onigiri05/AOC_final_project/PT_DIR/README.md

把權重檔`rms_qat_best.pt`放在這個目錄下
[權重檔連結](https://drive.google.com/file/d/1NLXP_AgiUWwAuHGhvn90UVlvVOJURX59/view?usp=sharing)
