onigiri05/AOC_final_project/DLA/Streaming_RMSNorm_Unit/hardware_export/gamma_buffer/gamma_buffer_params.csv

layer | entries | bits | format | q_frac | gamma_fp32_min | gamma_fp32_max | gamma_fp32_mean | clip_low | clip_high | mem | hex | npy | bytes
blocks.0.norm1 | 384 | 16 | INT16_SQ2.14_assumed | 14 | -0.0034103195648640394 | 1.004909634590149 | 0.45875516533851624 | 0 | 0 | ckpt_flash_attn/hardware_export/gamma_buffer/blocks_0_norm1_gamma_Q2_14.mem | ckpt_flash_attn/hardware_export/gamma_buffer/blocks_0_norm1_gamma_Q2_14.hex | ckpt_flash_attn/hardware_export/gamma_buffer/blocks_0_norm1_gamma_Q2_14.npy | 768
blocks.0.norm2 | 384 | 16 | INT16_SQ2.14_assumed | 14 | -0.014030483551323414 | 2.892163038253784 | 1.123841404914856 | 0 | 92 | ckpt_flash_attn/hardware_export/gamma_buffer/blocks_0_norm2_gamma_Q2_14.mem | ckpt_flash_attn/hardware_export/gamma_buffer/blocks_0_norm2_gamma_Q2_14.hex | ckpt_flash_attn/hardware_export/gamma_buffer/blocks_0_norm2_gamma_Q2_14.npy | 768
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
