onigiri05/AOC_final_project/DLA/Streaming_RMSNorm_Unit/hardware_export/rmsnorm_inv_sqrt_lut/per_layer_B/rms_inv_sqrt_lut_B_per_layer_params.csv

layer | safe_layer | scheme | lut_bits | n_entries | output_bits | output_format | q_frac | mean_sq_min | mean_sq_max | index_scale | error_max_percent | mem | hex | coe | npy | bytes | kb
blocks.0.norm1 | blocks_0_norm1 | B_per_layer | 10 | 1024 | 16 | UINT16_UQ2.14 | 14 | 0.0 | 9.184033298492432 | 111.38896895854313 | 0.705922510402496 | ckpt_flash_attn/hardware_export/rmsnorm_inv_sqrt_lut/per_layer_B/rms_inv_sqrt_lut_B_blocks_0_norm1_10bit_Q2_14.mem | ckpt_flash_attn/hardware_export/rmsnorm_inv_sqrt_lut/per_layer_B/rms_inv_sqrt_lut_B_blocks_0_norm1_10bit_Q2_14.hex | ckpt_flash_attn/hardware_export/rmsnorm_inv_sqrt_lut/per_layer_B/rms_inv_sqrt_lut_B_blocks_0_norm1_10bit_Q2_14.coe | ckpt_flash_attn/hardware_export/rmsnorm_inv_sqrt_lut/per_layer_B/rms_inv_sqrt_lut_B_blocks_0_norm1_10bit_Q2_14.npy | 2048 | 2.0
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
