onigiri05/AOC_final_project/Profiling/outputs/bram_bytes_by_section.png

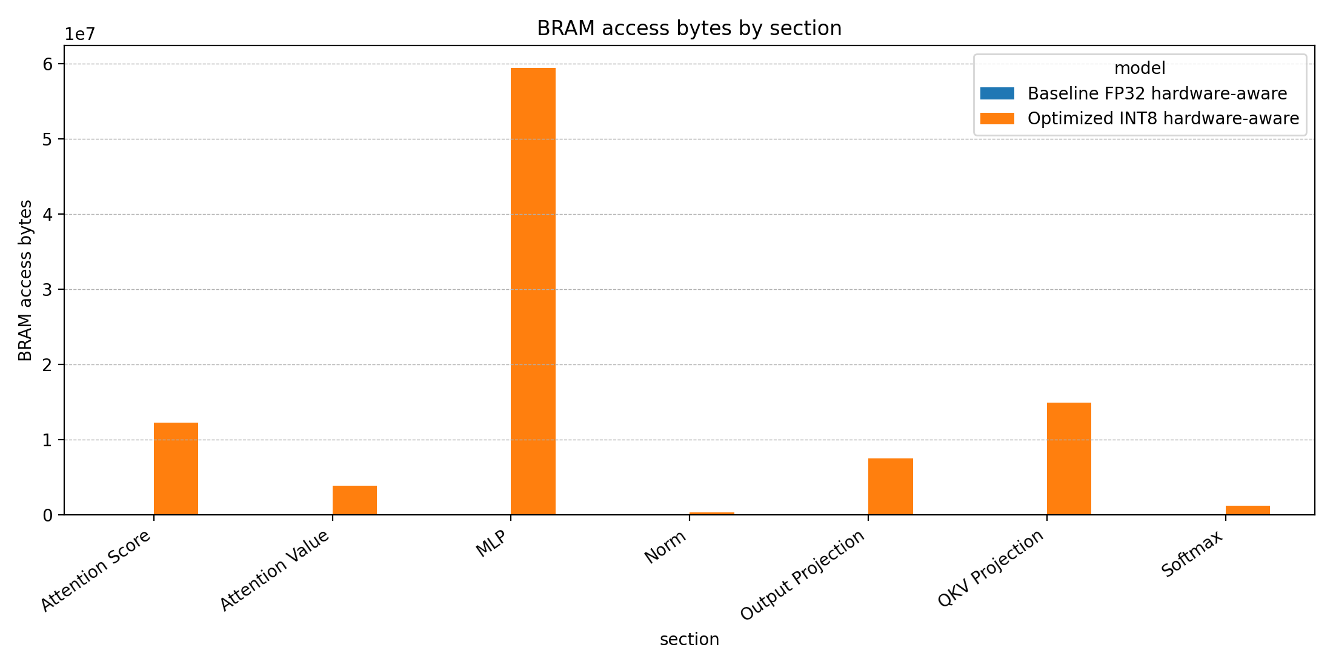
Profiling/outputs/bram_bytes_by_section.png
