onigiri05/AOC_final_project/Profiling/outputs/cycles_by_section.png

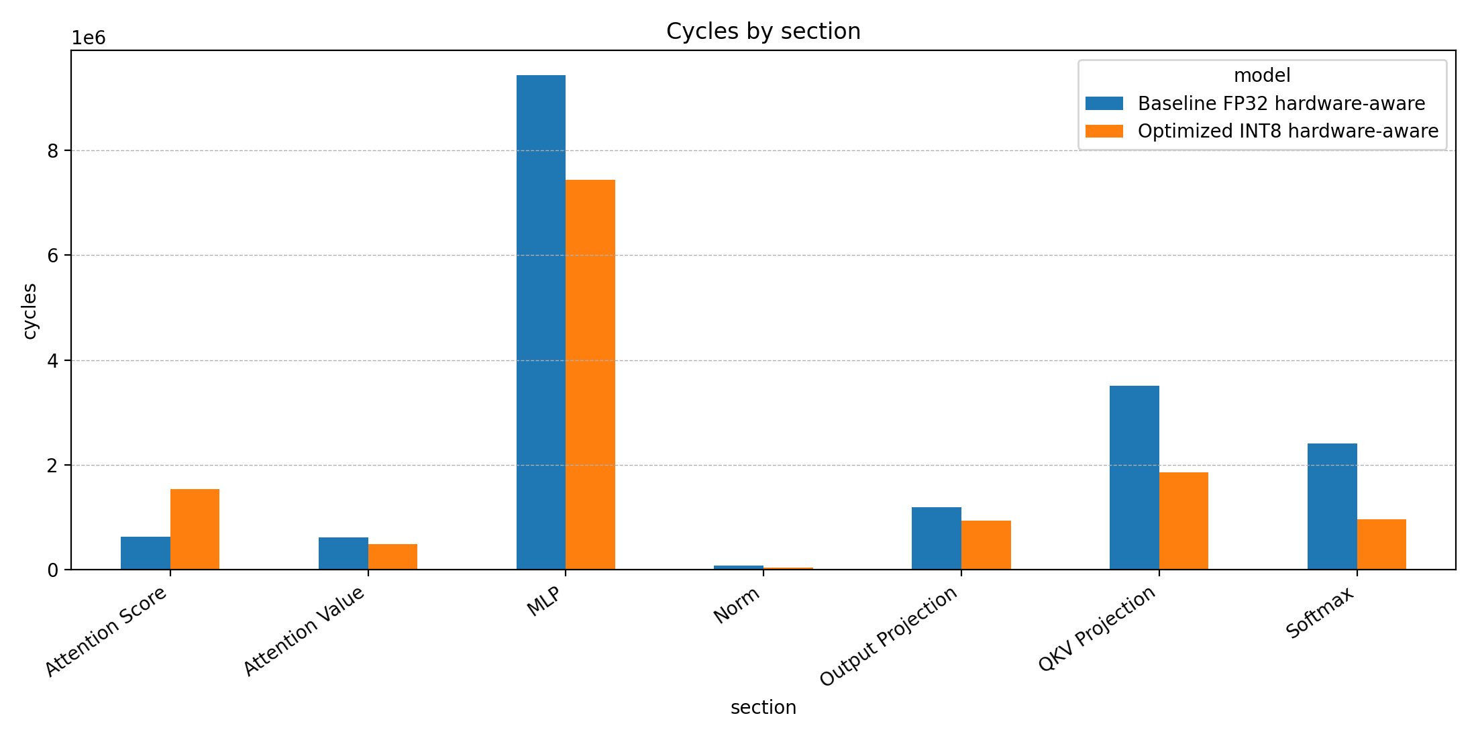
Profiling/outputs/cycles_by_section.png
