onigiri05/AOC_final_project/Profiling/outputs/cycles_norm_softmax.png

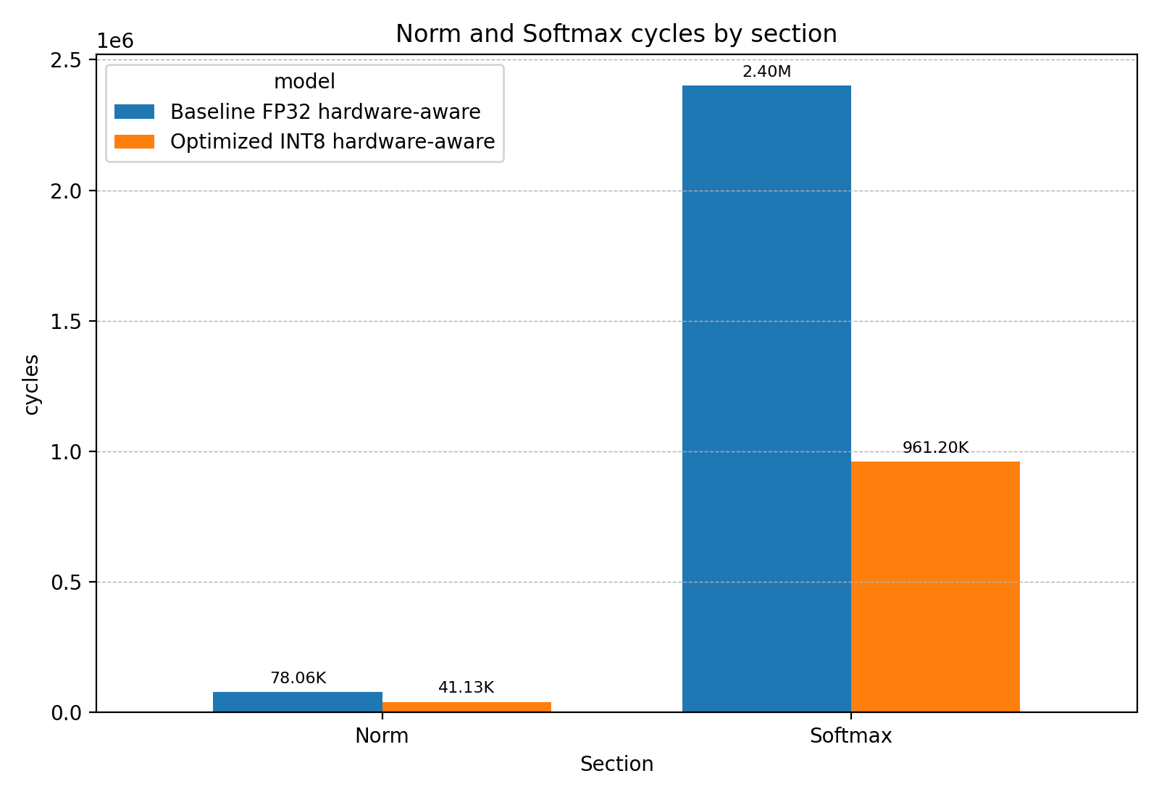
Profiling/outputs/cycles_norm_softmax.png
