onigiri05/AOC_final_project/Profiling/outputs/dram_bram_access_by_section.png

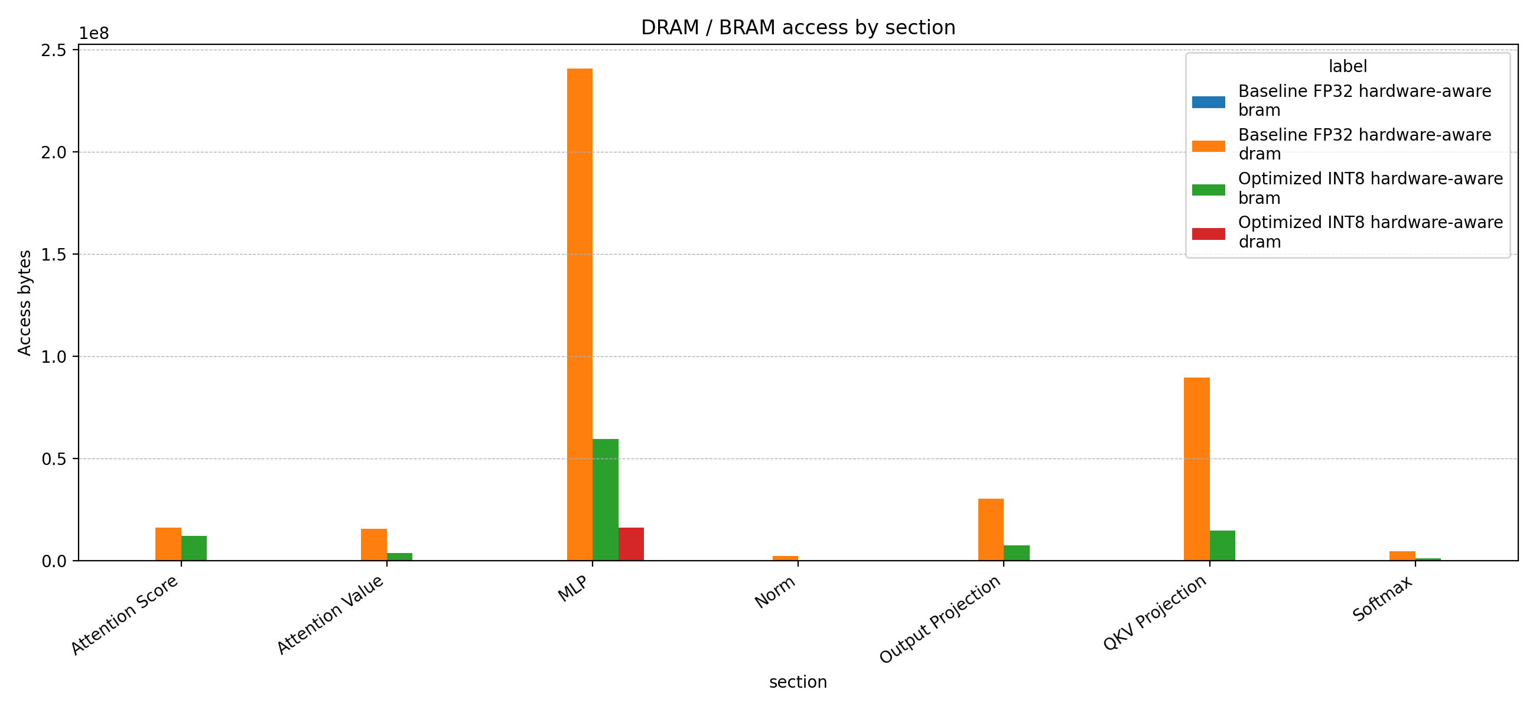
Profiling/outputs/dram_bram_access_by_section.png
