onigiri05/AOC_final_project/Profiling/outputs/energy_by_section.png

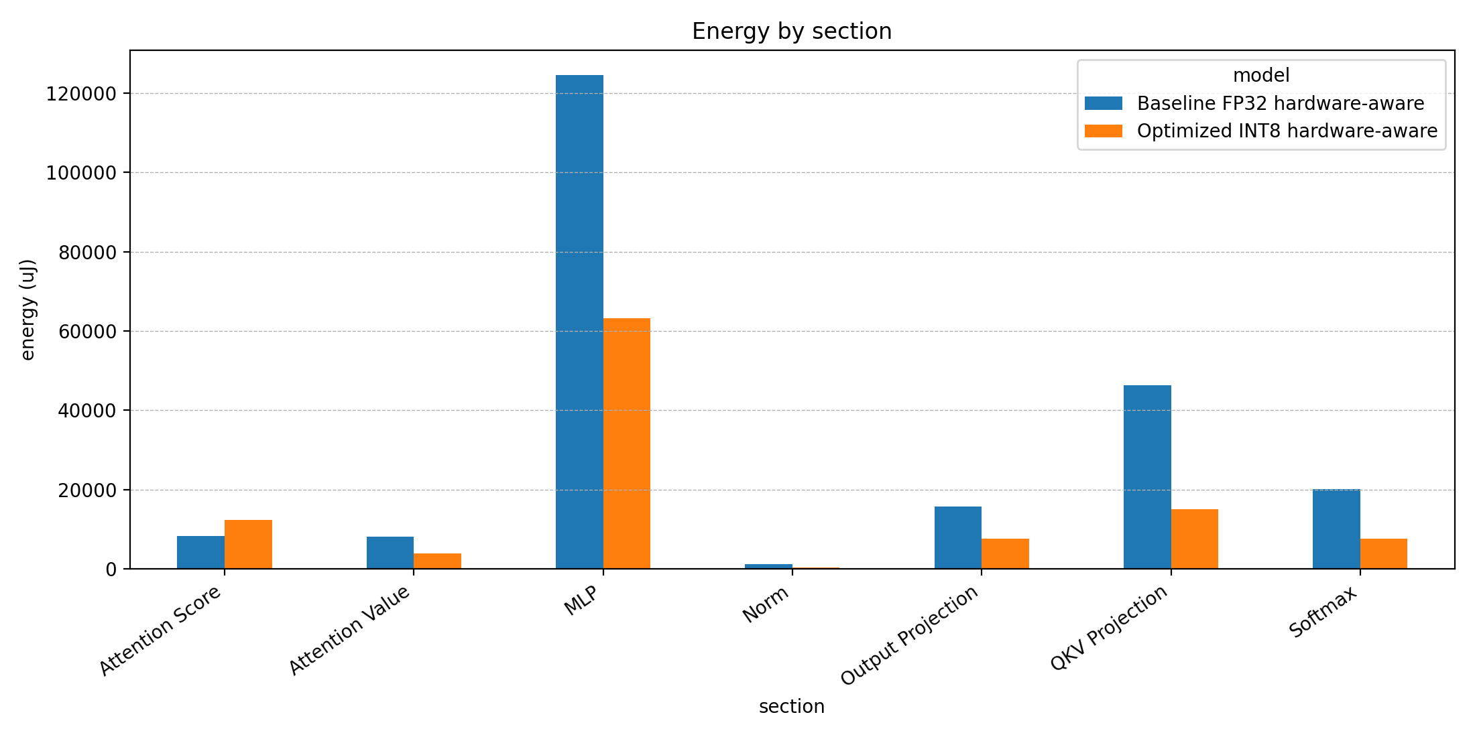
Profiling/outputs/energy_by_section.png
