onigiri05/AOC_final_project/Profiling/outputs/macs_by_section.png

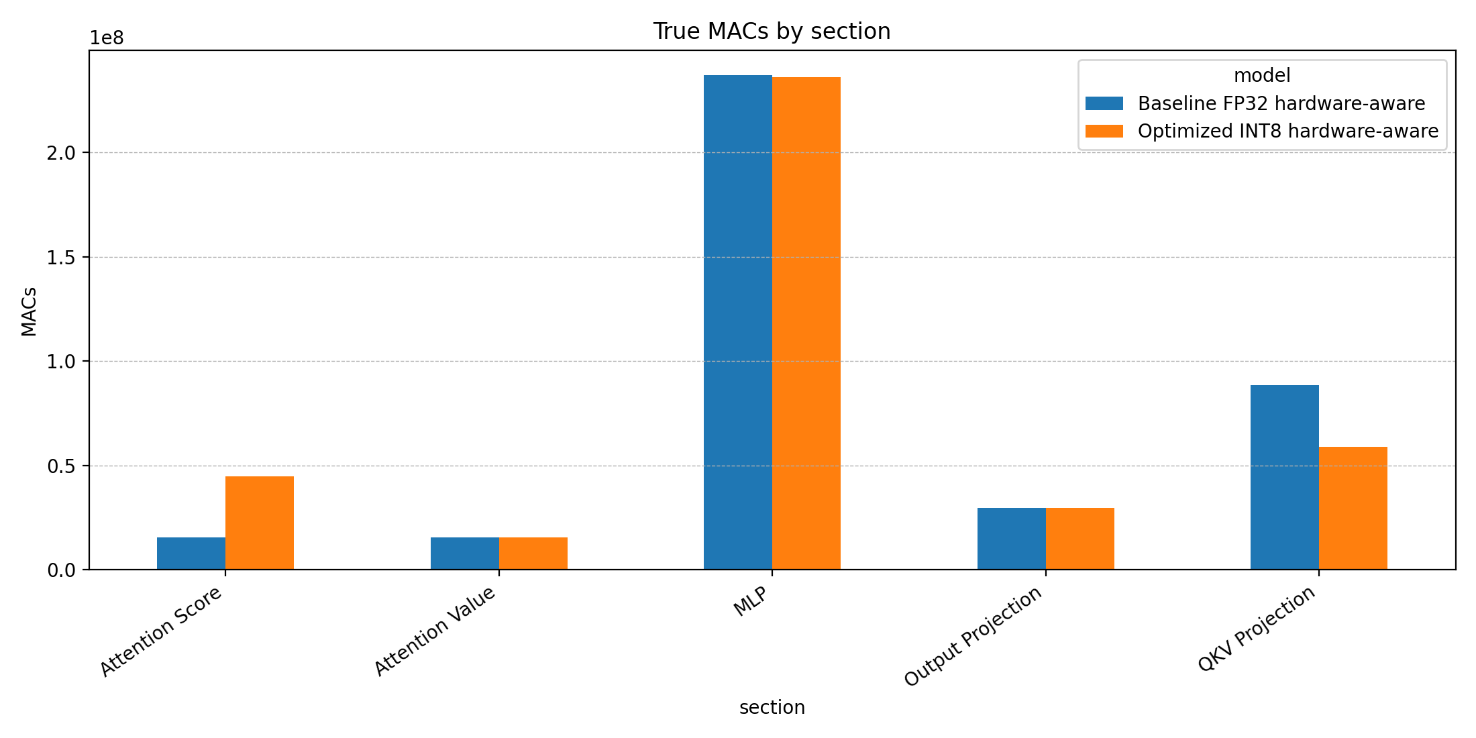
Profiling/outputs/macs_by_section.png
