onigiri05/AOC_final_project/Profiling/outputs/roofline_groups.png

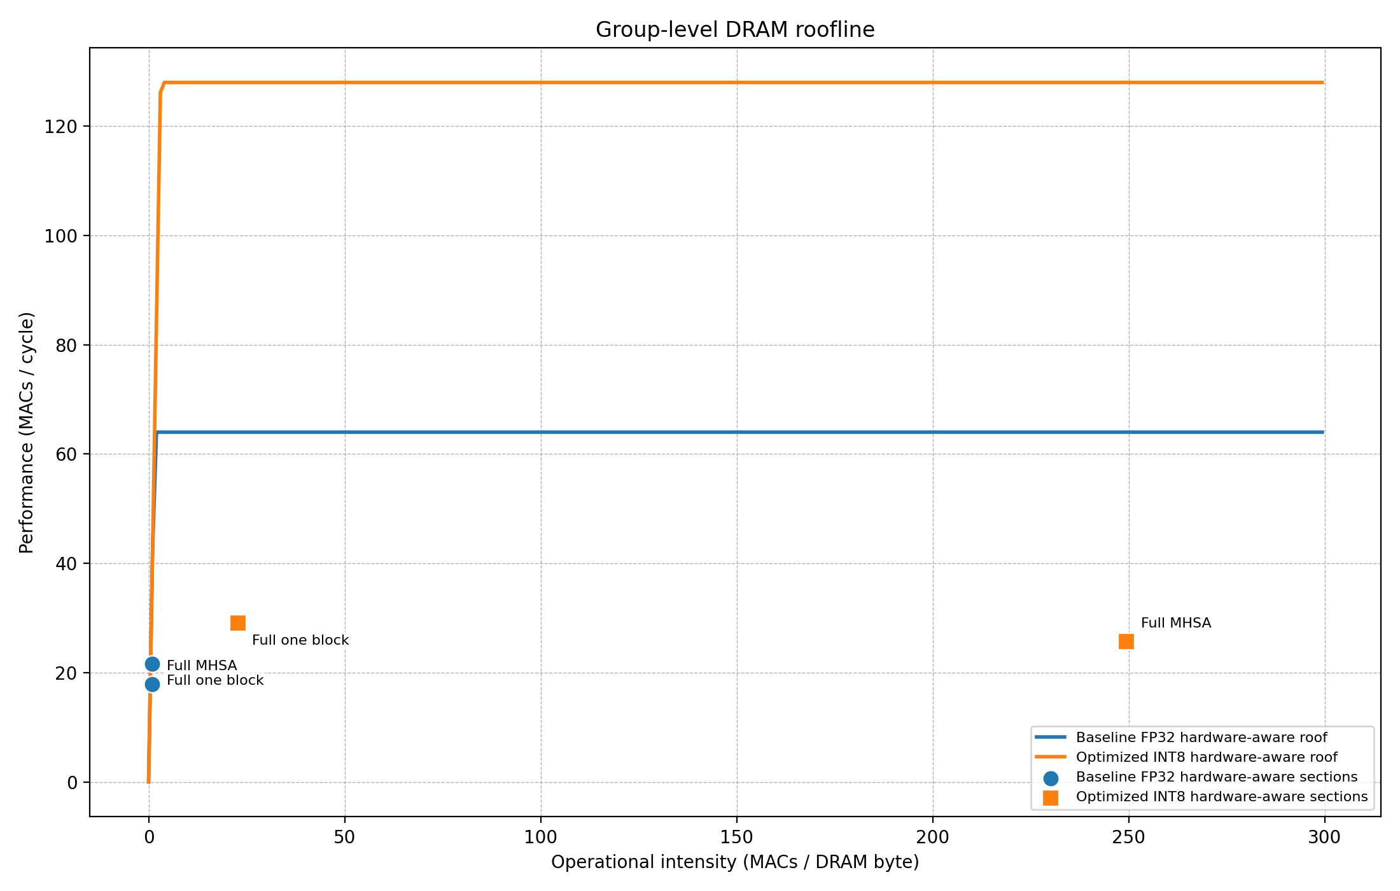
Profiling/outputs/roofline_groups.png
