onigiri05/AOC_final_project/Profiling/outputs/roofline_sections.png

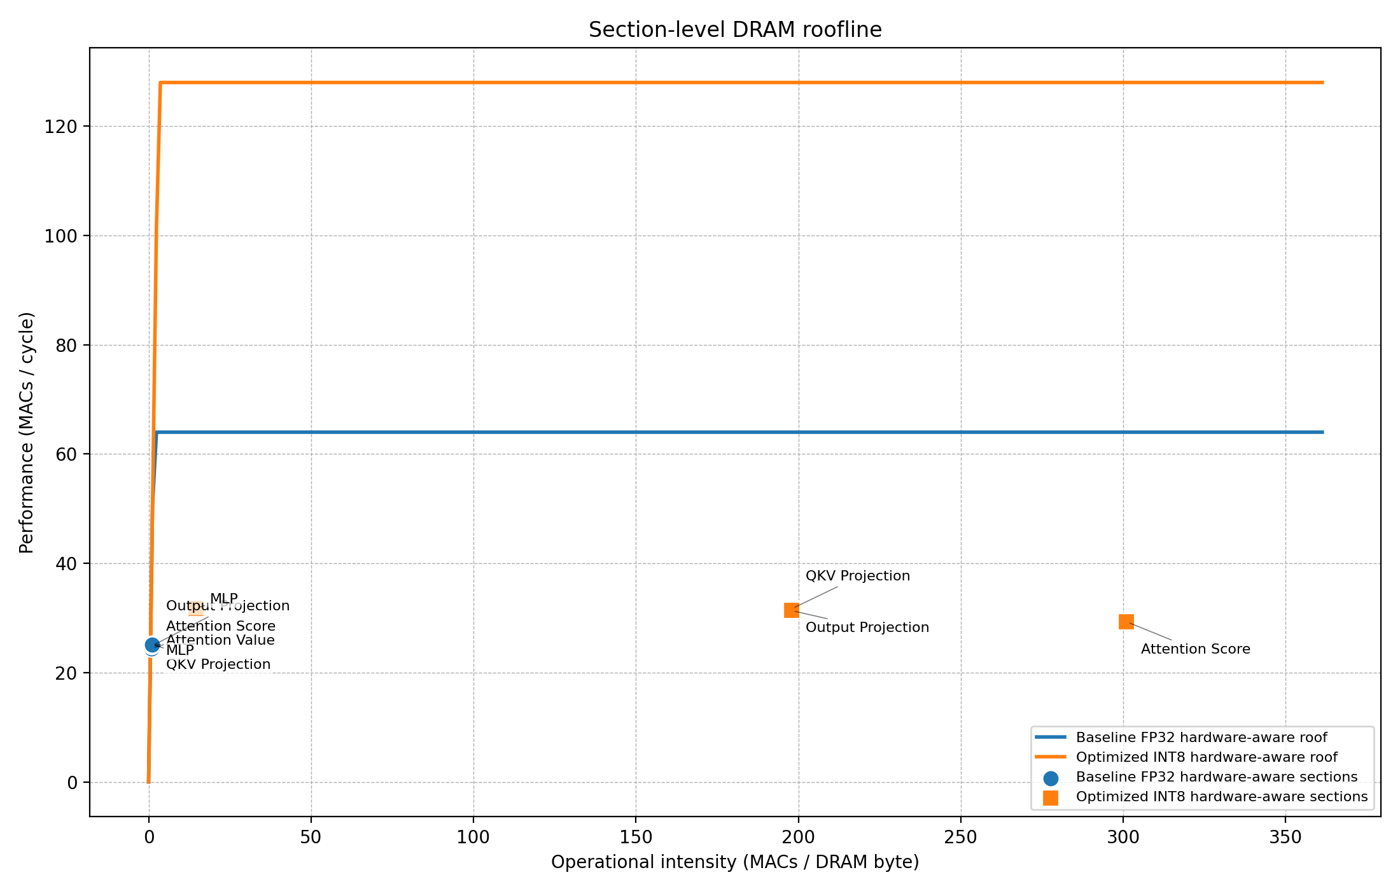
Profiling/outputs/roofline_sections.png
