onigiri05/AOC_final_project/Profiling/outputs/dram_usage_by_section.png

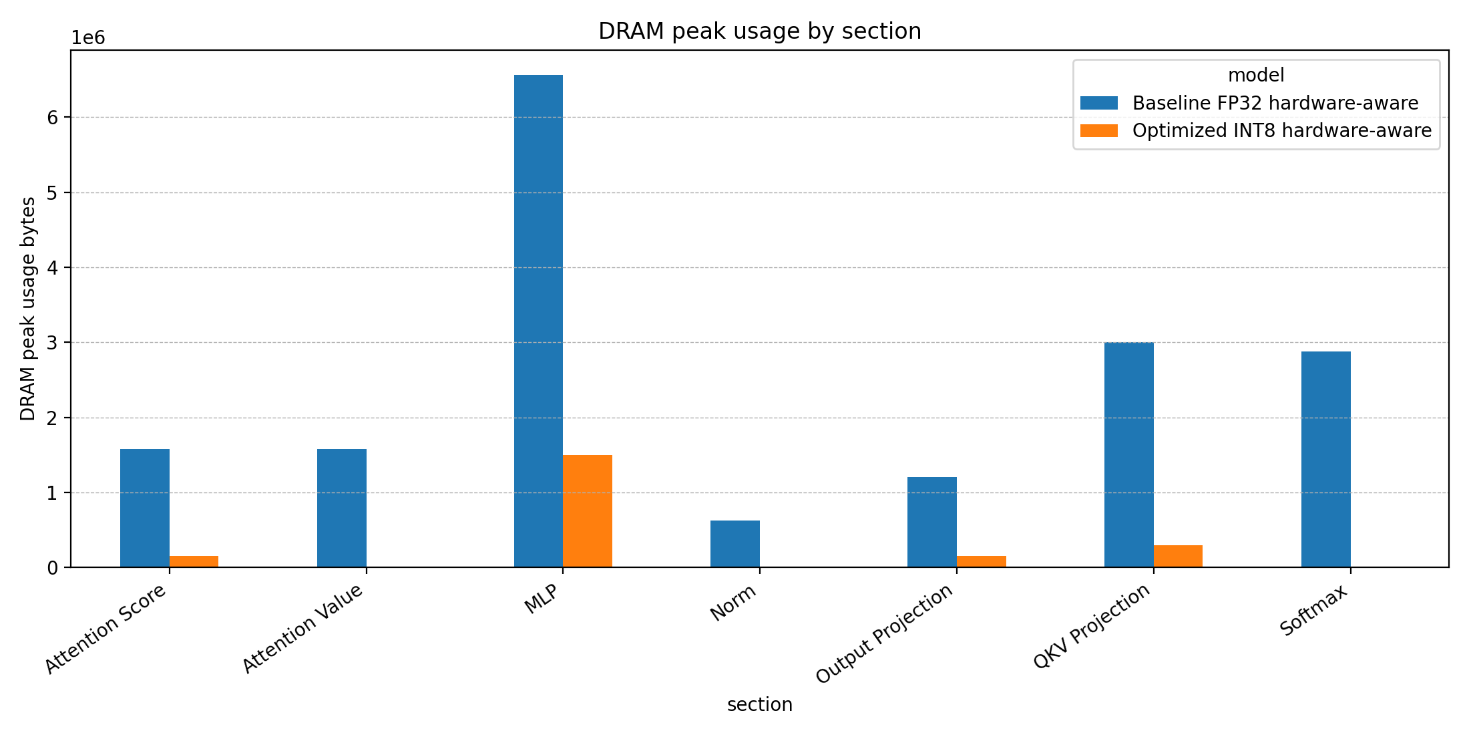
Profiling/outputs/dram_usage_by_section.png
