onigiri05/AOC_final_project/Profiling/outputs/norm_operations_by_section.png

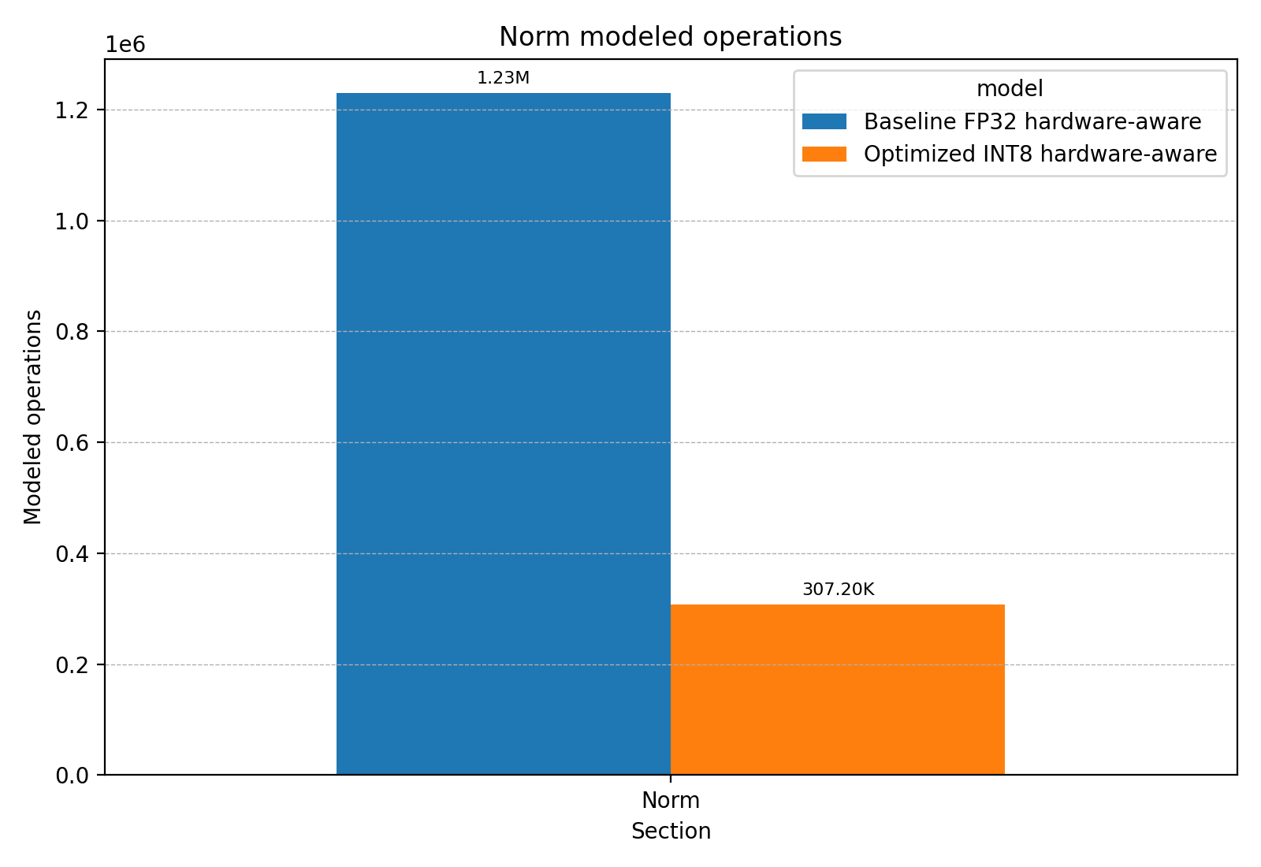
Profiling/outputs/norm_operations_by_section.png
