onigiri05/AOC_final_project/Profiling/outputs/profiling_results.md

| model | model_source | section | kind | dtype | macs | math_macs | operations | lut_accesses | dram_read_bytes | dram_write_bytes | dram_total_bytes | bram_read_bytes | bram_write_bytes | bram_total_bytes | dram_usage_bytes | bram_usage_bytes | bram_usage_ramb36 | compute_cycles | dram_cycles | bram_cycles | memory_cycles | cycles_total | latency_ms | performance_macs_per_cycle | operational_intensity | total_memory_intensity | peak_macs_per_cycle | peak_dram_bytes_per_cycle | bound | energy_compute_uj | energy_bram_uj | energy_dram_uj | energy_lut_uj | energy_leakage_uj | energy_total_uj | notes |
|:---|:---|:---|:---|:---|---:|---:|---:|---:|---:|---:|---:|---:|---:|---:|---:|---:|---:|---:|---:|---:|---:|---:|---:|---:|---:|---:|---:|---:|:---|---:|---:|---:|---:|---:|---:|:---|
| Baseline FP32 hardware-aware  | parsed_from_timm | Norm | elementwise | FP32 | 0 | 0 | 1229600 | 0 | 1854144 | 617600 | 2471744 | 0 | 0 | 0 | 623744 | 0 | 0 | 19212.5 |  58851 | 0 |  58851 |  78063.5 | 3.12254 | 0 | nan | nan | 64 | 42 | memory | 4.9184 | 0 | 494.349  | 0 | 624.508 | 1123.78  | Baseline-B: FP32 all-DRAM tiled model using the same RTL 8x8 tile size; no BRAM reuse. LayerNorm true MACs are 0; detailed modeled operations are reported separately. |
| Baseline FP32 hardware-aware  | parsed_from_timm | QKV Projection | gemm | FP32 |  88473600 | 88473600 | 0 | 0 | 88588800 | 921600 | 89510400 | 0 | 0 | 0 | 3002880 | 0 | 0 | 1.3824e+06 | 2.1312e+06  | 0 | 2.1312e+06  | 3.5136e+06  | 140.544 | 25.1803 | 0.988417 | 0.988417 | 64 | 42 | memory | 353.894  | 0 | 17902.1 | 0 | 28108.8 | 46364.8 | Baseline-B: FP32 all-DRAM tiled model using the same RTL 8x8 tile size; no BRAM reuse. |
| Baseline FP32 hardware-aware  | parsed_from_timm | Attention Score | gemm | FP32 |  15360000 | 15360000 | 0 | 0 | 15360000 | 960000 | 16320000 | 0 | 0 | 0 | 1574400 | 0 | 0 |  240000 | 388571 | 0 | 388571 | 628571 | 25.1429  | 24.4364 | 0.941176 | 0.941176 | 64 | 42 | memory | 61.44 | 0 | 3264 | 0 | 5028.57  | 8354.01  | Baseline-B: FP32 all-DRAM tiled model using the same RTL 8x8 tile size; no BRAM reuse. |
| Baseline FP32 hardware-aware  | parsed_from_timm | Softmax | softmax | FP32 | 0 | 0 | 2400000 | 0 | 2880000 | 1920000 | 4800000 | 0 | 0 | 0 | 2880000 | 0 | 0 | 37500 | 114286 | 0 | 114286 | 2.4012e+06  | 96.048 | 0 | nan | nan | 64 | 42 | memory | 9.6 | 0 | 960 | 0 | 19209.6 | 20179.2 | Baseline-B: FP32 all-DRAM tiled model using the same RTL 8x8 tile size; no BRAM reuse. Standard FP32 softmax all-DRAM memory model. True MACs are 0 because Softmax is non-GEMM; the operations column reports modeled row-wise softmax cost with FP32 exp/div initiation intervals exp_ii=4, div_ii=4. Baseline FP32 Softmax uses row-wise FSM latency with explicit exp/div IIs: rows*((2+exp_ii+div_ii)*Tp+overhead) = 1200*((2+4+4)*200+1). |
| Baseline FP32 hardware-aware  | parsed_from_timm | Attention Value | gemm | FP32 |  15360000 | 15360000 | 0 | 0 | 15360000 | 307200 | 15667200 | 0 | 0 | 0 | 1574400 | 0 | 0 |  240000 | 373029 | 0 | 373029 | 613029 | 24.5211  | 25.0559 | 0.980392 | 0.980392 | 64 | 42 | memory | 61.44 | 0 | 3133.44 | 0 | 4904.23  | 8099.11  | Baseline-B: FP32 all-DRAM tiled model using the same RTL 8x8 tile size; no BRAM reuse. |
| Baseline FP32 hardware-aware  | parsed_from_timm | Output Projection | gemm_elementwise | FP32 |  29491200 | 29491200 | 0 | 0 | 29836800 | 614400 | 30451200 | 0 | 0 | 0 | 1205760 | 0 | 0 |  460800 | 725029 | 0 | 725029 | 1.18583e+06 | 47.4331  | 24.8697 | 0.968474 | 0.968474 | 64 | 42 | memory | 117.965  | 0 | 6090.24 | 0 | 9486.63  | 15694.8 | Baseline-B: FP32 all-DRAM tiled model using the same RTL 8x8 tile size; no BRAM reuse. |
| Baseline FP32 hardware-aware  | parsed_from_timm | MLP | gemm_elementwise | FP32 | 237158400 | 237158400 | 0 | 0 | 237657600 | 3072000 | 240729600 | 0 | 0 | 0 | 6569472 | 0 | 0 | 3.7056e+06 | 5.73166e+06 | 0 | 5.73166e+06 | 9.43726e+06 | 377.49 | 25.13 | 0.985165 | 0.985165 | 64 | 42 | memory | 948.634  | 0 | 48145.9 | 0 | 75498.1 | 124593 | Baseline-B: FP32 all-DRAM tiled model using the same RTL 8x8 tile size; no BRAM reuse. No FC1+GELU fusion: hidden activation is materialized in DRAM. |
| Optimized INT8 hardware-aware | fallback_default_checkpoint_parse_failed | Norm | elementwise | INT8/INT32 | 0 | 0 | 307200 | 400 | 1536 | 0 | 1536 | 155936 | 153600 | 309536 | 1536 | 155536 | 38 | 2400 | 36.5714 |  38692 |  38728.6 |  41128.6 | 1.64514 | 0 | nan | nan | 128 | 42 | on-chip-memory | 0.3072 | 1.54768 | 0.3072 | 0.0004 | 329.029 | 331.191 | Optimized INT8 RTL-aware model: 8x8 shared systolic, physical buffer lifetime/sharing, no PPU profiling. Streaming RMSNorm apply-only stage; true MACs are 0 and modeled operations are reported separately. |
| Optimized INT8 hardware-aware | fallback_default_checkpoint_parse_failed | QKV Projection | gemm | INT8/INT32 |  58982400 | 58982400 | 0 | 0 | 297984 | 0 | 297984 | 14745600 | 153600 | 14899200 | 297984 | 108544 | 27 |  460800 | 7094.86 | 1.8624e+06 | 1.86949e+06 | 1.8624e+06  | 74.496 | 31.6701 | 197.938 | 3.88114  | 128 | 42 | on-chip-memory | 58.9824 | 74.496 | 59.5968 | 0 | 14899.2 | 15092.3 | Optimized INT8 RTL-aware model: 8x8 shared systolic, physical buffer lifetime/sharing, no PPU profiling. K/V precompute only: full Q is not stored; current-head K/V buffers are used to reduce BRAM footprint. Ping-pong uses max(compute, DRAM preload, BRAM service) as the latency lower bound. |
| Optimized INT8 hardware-aware | fallback_default_checkpoint_parse_failed | Attention Score | gemm | INT8/INT32 |  44851200 | 44851200 | 0 | 0 | 148992 | 0 | 148992 | 11212800 | 1036800 | 12249600 | 148992 | 269056 | 66 |  350400 | 3547.43 | 1.5312e+06 | 1.53475e+06 | 1.5312e+06  | 61.248 | 29.2915 | 301.031 | 3.61744  | 128 | 42 | on-chip-memory | 44.8512 | 61.248 | 29.7984 | 0 | 12249.6 | 12385.5 | Optimized INT8 RTL-aware model: 8x8 shared systolic, physical buffer lifetime/sharing, no PPU profiling. Includes PH_Q_TILE recomputation before QK^T. Only a small current-query Q cache is live; full Q is not stored. Ping-pong uses max(compute, DRAM preload, BRAM service) as the latency lower bound. |
| Optimized INT8 hardware-aware | fallback_default_checkpoint_parse_failed | Softmax | softmax | INT8/INT32 | 0 | 0 | 960000 | 240000 | 0 | 0 | 0 | 960000 | 240000 | 1200000 | 0 | 249600 | 61 | 7500 | 0 | 150000 | 150000 | 961200 | 38.448 | 0 | nan | nan | 128 | 42 | on-chip | 0.96 | 6 | 0 | 0.24 | 7689.6 | 7696.8 | Optimized INT8 RTL-aware model: 8x8 shared systolic, physical buffer lifetime/sharing, no PPU profiling. Score/A share BRAM; row input/output is streamed. Softmax true MACs are 0. The operations column reports modeled LUT/fixed-point row-wise cost with lut_ii=1, norm_ii=1. Optimized LUT Softmax uses row-wise FSM latency: rows*((2+lut_ii+norm_ii)*Tp+overhead) = 1200*((2+1+1)*200+1). |
| Optimized INT8 hardware-aware | fallback_default_checkpoint_parse_failed | Attention Value | gemm | INT8/INT32 |  15360000 | 15360000 | 0 | 0 | 0 | 0 | 0 | 3840000 | 76800 | 3916800 | 0 | 206400 | 51 |  120000 | 0 | 489600 | 489600 | 489600 | 19.584 | 31.3725 | nan | 3.92157  | 128 | 42 | on-chip | 15.36 | 19.584 | 0 | 0 | 3916.8 | 3951.74  | Optimized INT8 RTL-aware model: 8x8 shared systolic, physical buffer lifetime/sharing, no PPU profiling. A from shared Score/A BRAM and current-head V from u_v_xmid_bram; O_attn is written into u_norm_bram. Ping-pong uses max(compute, DRAM preload, BRAM service) as the latency lower bound. |
| Optimized INT8 hardware-aware | fallback_default_checkpoint_parse_failed | Output Projection | gemm_elementwise | INT8/INT32 |  29491200 | 29491200 | 0 | 0 | 148992 | 0 | 148992 | 7449600 | 76800 | 7526400 | 148992 | 159744 | 39 |  230400 | 3547.43 | 940800 | 944347 | 940800 | 37.632 | 31.3469 | 197.938 | 3.84231  | 128 | 42 | on-chip-memory | 29.4912 | 37.632 | 29.7984 | 0 | 7526.4 | 7623.32  | Optimized INT8 RTL-aware model: 8x8 shared systolic, physical buffer lifetime/sharing, no PPU profiling. O_attn is read from u_norm_bram; residual X is read from u_x_bram; X_mid is written into u_v_xmid_bram. Ping-pong uses max(compute, DRAM preload, BRAM service) as the latency lower bound. |
| Optimized INT8 hardware-aware | fallback_default_checkpoint_parse_failed | MLP | gemm_elementwise | INT8/INT32 | 235929600 | 235929600 | 0 | 307200 | 15932928 | 307200 | 16240128 | 59059200 | 384000 | 59443200 | 1494528 | 179200 | 44 | 1.8432e+06 | 386670 | 7.4304e+06 | 7.81707e+06 | 7.4304e+06  | 297.216 | 31.7519 | 14.5276 | 3.11733  | 128 | 42 | on-chip-memory | 235.93 | 297.216 | 3248.03 | 0.3072 | 59443.2 | 63224.7 | Optimized INT8 RTL-aware model: 8x8 shared systolic, physical buffer lifetime/sharing, no PPU profiling. FC1+GELU uses a 1K-word page BRAM and DDR page streaming. Full hidden_gelu is not kept on chip; FC2 hidden DDR reload factor is 48. Ping-pong uses max(compute, DRAM preload, BRAM service) as the latency lower bound. |
