onigiri05/AOC_final_project/Profiling/outputs/profiling_results.csv

model | model_source | section | kind | dtype | macs | math_macs | operations | lut_accesses | dram_read_bytes | dram_write_bytes | dram_total_bytes | bram_read_bytes | bram_write_bytes | bram_total_bytes | dram_usage_bytes | bram_usage_bytes | bram_usage_ramb36 | compute_cycles | dram_cycles | bram_cycles | memory_cycles | cycles_total | latency_ms | performance_macs_per_cycle | operational_intensity | total_memory_intensity | peak_macs_per_cycle | peak_dram_bytes_per_cycle | bound | energy_compute_uj | energy_bram_uj | energy_dram_uj | energy_lut_uj | energy_leakage_uj | energy_total_uj | notes
Baseline FP32 hardware-aware | parsed_from_timm | Norm | elementwise | FP32 | 0 | 0 | 1229600 | 0 | 1854144 | 617600 | 2471744 | 0 | 0 | 0 | 623744 | 0 | 0 | 19212.5 | 58851.04761904762 | 0.0 | 58851.04761904762 | 78063.54761904762 | 3.1225419047619045 | 0.0 |  |  | 64.0 | 42.0 | memory | 4.9184 | 0.0 | 494.3488 | 0.0 | 624.5083809523809 | 1123.775580952381 | Baseline-B: FP32 all-DRAM tiled model using the same RTL 8x8 tile size; no BRAM reuse. LayerNorm true MACs are 0; detailed modeled operations are reported separately.
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
