onigiri05/AOC_final_project/model_verification/results/full_summary.csv

Exp ID | Method | Bits | Top-1(%) | Macro-F1 | Drop_vs_RMSFP32(pp) | Category
EXP-DECOMP-LN | LN-FP32 (pretrained) | 32 | 74.27 | 0.7414 | -11.577 | Decomp
EXP-DECOMP-RMS | RMS-FP32 (baseline) | 32 | 62.69 | 0.6235 | 0.0 | Decomp
EXP-FP16 | FP16 | 16 | 62.69 | 0.6234 | 0.0 | FP16
EXP-MP-FP32 | INT8(bulk)+FP32(sensitive) | 8+mix | 62.67 | 0.6233 | 0.021 | Mixed-P
EXP-MP-INT16 | INT8(bulk)+INT16(sensitive) | 8+mix | 62.66 | 0.6232 | 0.031 | Mixed-P
EXP-MP-INT12 | INT8(bulk)+INT12(sensitive) | 8+mix | 62.66 | 0.6232 | 0.031 | Mixed-P
EXP-BW-INT12 | PTQ-MinMax-PC-INT12 | 12 | 62.72 | 0.6237 | -0.021 | PTQ-BW
EXP-BW-INT16 | PTQ-MinMax-PC-INT16 | 16 | 62.7 | 0.6236 | -0.01 | PTQ-BW
EXP-BW-INT4 | PTQ-MinMax-PC-INT4 | 4 | 51.27 | 0.5101 | 11.422 | PTQ-BW
EXP-BW-INT6 | PTQ-MinMax-PC-INT6 | 6 | 62.19 | 0.6183 | 0.505 | PTQ-BW
EXP-BW-INT8 | PTQ-MinMax-PC-INT8 | 8 | 62.61 | 0.6225 | 0.082 | PTQ-BW
EXP-CAL-MinMax | PTQ-INT8-PC-MinMax | 8 | 62.61 | 0.6225 | 0.082 | PTQ-CAL
EXP-CAL-Pct-99.9% | PTQ-INT8-PC-Pct-99.9% | 8 | 62.14 | 0.6181 | 0.556 | PTQ-CAL
EXP-CAL-Pct-99.99% | PTQ-INT8-PC-Pct-99.99% | 8 | 62.62 | 0.623 | 0.072 | PTQ-CAL
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
