onigiri05/AOC_final_project/model_verification/results/mcnemar_all.csv

Experiment | Bits | Top-1(%) | Macro-F1 | Drop(pp) | n01 | n10 | chi2 | p-value | Sig?
LN-FP32（架構效應對照） | 32 | 74.27 | 0.7414 | -11.577 | 1698 | 574 | 555.074 | 0.0 | * sig
FP16 | 16 | 62.69 | 0.6234 | 0.0 | 2 | 2 | 0.25 | 0.6171 | n.s.
PTQ INT4 | 4 | 51.27 | 0.5101 | 11.422 | 320 | 1429 | 701.923 | 0.0 | * sig
PTQ INT6 | 6 | 62.19 | 0.6183 | 0.505 | 143 | 192 | 6.878 | 0.0087 | * sig
PTQ INT8 | 8 | 62.61 | 0.6225 | 0.082 | 41 | 49 | 0.544 | 0.4606 | n.s.
PTQ INT12 | 12 | 62.72 | 0.6237 | -0.021 | 4 | 2 | 0.167 | 0.6831 | n.s.
PTQ INT16 | 16 | 62.7 | 0.6236 | -0.01 | 1 | 0 | 0.0 | 1.0 | n.s.
INT8 PT | 8 | 62.14 | 0.6178 | 0.556 | 116 | 170 | 9.822 | 0.0017 | * sig
INT8 PC | 8 | 62.61 | 0.6225 | 0.082 | 41 | 49 | 0.544 | 0.4606 | n.s.
INT8 PB | 8 | 61.93 | 0.6162 | 0.762 | 174 | 248 | 12.628 | 0.0004 | * sig
INT12 PT | 12 | 62.74 | 0.6239 | -0.041 | 10 | 6 | 0.562 | 0.4533 | n.s.
INT12 PC | 12 | 62.72 | 0.6237 | -0.021 | 4 | 2 | 0.167 | 0.6831 | n.s.
INT12 PB | 12 | 62.69 | 0.6234 | 0.0 | 12 | 12 | 0.042 | 0.8383 | n.s.
INT16 PT | 16 | 62.72 | 0.6237 | -0.021 | 2 | 0 | 0.5 | 0.4795 | n.s.
INT16 PC | 16 | 62.7 | 0.6236 | -0.01 | 1 | 0 | 0.0 | 1.0 | n.s.
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
