onigiri05/AOC_final_project/FPGA/vit_fulldesign_rtl/Streaming_RMSNorm_Unit/RMSNorm_Fusion_ROMs_Case_All.sv

`timescale 1ns/1ps

// ============================================================
// Module: RMSInvSqrtAddrGen_A_Global
//
// Purpose:
//   Convert raw RMS sum_sq into the 10-bit address for
//   RMSInvSqrtLUT_A_Global_Case.
//
// From software params:
//   mean_sq = sum_sq / 384
//   idx = clamp(round(mean_sq * 3.6303390809), 0, 1023)
//
// Combined:
//   idx = clamp(round(sum_sq * (3.6303390809 / 384)), 0, 1023)
//
// This module uses Q16 fixed-point coefficient:
//   INDEX_SCALE_OVER_CHANNEL_Q = round((3.6303390809 / 384) * 2^16)
//                              = 620
// ============================================================

module RMSInvSqrtAddrGen_A_Global #(
    parameter int SUM_W  = 32,
    parameter int ADDR_W = 10,
    parameter int SCALE_Q = 16,
    parameter int INDEX_SCALE_OVER_CHANNEL_Q = 620
)(
    input  logic [SUM_W-1:0]  sum_sq_i,
    output logic [ADDR_W-1:0] lut_addr_o
);

    logic [63:0] prod;
    logic [63:0] idx_round;

    always_comb begin
        prod      = {{(64-SUM_W){1'b0}}, sum_sq_i} * INDEX_SCALE_OVER_CHANNEL_Q;
        idx_round = (prod + (64'd1 << (SCALE_Q-1))) >> SCALE_Q;

        if (idx_round > 64'd1023)
            lut_addr_o = {ADDR_W{1'b1}};
        else
            lut_addr_o = idx_round[ADDR_W-1:0];
    end

endmodule


`timescale 1ns/1ps

// ============================================================
// Module: RMSInvSqrtLUT_A_Global_Case
// RMSNorm Inv-Sqrt LUT, scheme A_global.
// Input meaning  : LUT address.
// Output meaning : inv_rms in UINT16 UQ2.14.
// Original formula from params:
//   idx = clamp(round(mean_sq * 3.6303390809), 0, 1023)
//   mean_sq_max = 281.79185943603517
// Entries: 1024 x 16-bit.
//
// Combinational case-based ROM.
// addr_i is the ROM address, data_o is the lookup result.
// ============================================================
module RMSInvSqrtLUT_A_Global_Case (
    input  logic [9:0] addr_i,
    output logic [15:0] data_o
);

    always_comb begin
        unique case (addr_i)
            10'd   0: data_o = 16'h79F1;
            10'd   1: data_o = 16'h79F1;
            10'd   2: data_o = 16'h563A;
            10'd   3: data_o = 16'h4667;
            10'd   4: data_o = 16'h3CF9;
            10'd   5: data_o = 16'h3689;
            10'd   6: data_o = 16'h31C8;
            10'd   7: data_o = 16'h2E17;
            10'd   8: data_o = 16'h2B1D;
            10'd   9: data_o = 16'h28A6;
            10'd  10: data_o = 16'h2690;
            10'd  11: data_o = 16'h24C4;
            10'd  12: data_o = 16'h2334;
            10'd  13: data_o = 16'h21D2;
            10'd  14: data_o = 16'h2097;
            10'd  15: data_o = 16'h1F7C;
            10'd  16: data_o = 16'h1E7C;
            10'd  17: data_o = 16'h1D93;
            10'd  18: data_o = 16'h1CBE;
            10'd  19: data_o = 16'h1BFA;
            10'd  20: data_o = 16'h1B44;
            10'd  21: data_o = 16'h1A9C;
            10'd  22: data_o = 16'h1A00;
            10'd  23: data_o = 16'h196D;
            10'd  24: data_o = 16'h18E4;
            10'd  25: data_o = 16'h1863;
            10'd  26: data_o = 16'h17EA;
            10'd  27: data_o = 16'h1778;
            10'd  28: data_o = 16'h170B;
            10'd  29: data_o = 16'h16A5;
            10'd  30: data_o = 16'h1643;
            10'd  31: data_o = 16'h15E7;
            10'd  32: data_o = 16'h158E;
            10'd  33: data_o = 16'h153A;
            10'd  34: data_o = 16'h14EA;
            10'd  35: data_o = 16'h149D;
            10'd  36: data_o = 16'h1453;
            10'd  37: data_o = 16'h140C;
            10'd  38: data_o = 16'h13C8;
            10'd  39: data_o = 16'h1387;
            10'd  40: data_o = 16'h1348;
            10'd  41: data_o = 16'h130B;
            10'd  42: data_o = 16'h12D1;
            10'd  43: data_o = 16'h1299;
            10'd  44: data_o = 16'h1262;
            10'd  45: data_o = 16'h122E;
            10'd  46: data_o = 16'h11FB;
            10'd  47: data_o = 16'h11C9;
            10'd  48: data_o = 16'h119A;
            10'd  49: data_o = 16'h116C;
            10'd  50: data_o = 16'h113F;
            10'd  51: data_o = 16'h1113;
            10'd  52: data_o = 16'h10E9;
            10'd  53: data_o = 16'h10C0;
            10'd  54: data_o = 16'h1098;
            10'd  55: data_o = 16'h1071;
            10'd  56: data_o = 16'h104C;
            10'd  57: data_o = 16'h1027;
            10'd  58: data_o = 16'h1003;
            10'd  59: data_o = 16'h0FE0;
            10'd  60: data_o = 16'h0FBE;
            10'd  61: data_o = 16'h0F9D;
            10'd  62: data_o = 16'h0F7D;
            10'd  63: data_o = 16'h0F5D;
            10'd  64: data_o = 16'h0F3E;
            10'd  65: data_o = 16'h0F20;
            10'd  66: data_o = 16'h0F03;
            10'd  67: data_o = 16'h0EE6;
            10'd  68: data_o = 16'h0ECA;
            10'd  69: data_o = 16'h0EAE;
            10'd  70: data_o = 16'h0E93;
            10'd  71: data_o = 16'h0E79;
            10'd  72: data_o = 16'h0E5F;
            10'd  73: data_o = 16'h0E46;
            10'd  74: data_o = 16'h0E2D;
            10'd  75: data_o = 16'h0E15;
            10'd  76: data_o = 16'h0DFD;
            10'd  77: data_o = 16'h0DE6;
            10'd  78: data_o = 16'h0DCF;
            10'd  79: data_o = 16'h0DB8;
            10'd  80: data_o = 16'h0DA2;
            10'd  81: data_o = 16'h0D8D;
            10'd  82: data_o = 16'h0D77;
            10'd  83: data_o = 16'h0D63;
            10'd  84: data_o = 16'h0D4E;
            10'd  85: data_o = 16'h0D3A;
            10'd  86: data_o = 16'h0D26;
            10'd  87: data_o = 16'h0D13;
            10'd  88: data_o = 16'h0D00;
            10'd  89: data_o = 16'h0CED;
            10'd  90: data_o = 16'h0CDB;
            10'd  91: data_o = 16'h0CC8;
            10'd  92: data_o = 16'h0CB7;
            10'd  93: data_o = 16'h0CA5;
            10'd  94: data_o = 16'h0C94;
            10'd  95: data_o = 16'h0C83;
            10'd  96: data_o = 16'h0C72;
            10'd  97: data_o = 16'h0C62;
            10'd  98: data_o = 16'h0C51;
            10'd  99: data_o = 16'h0C41;
            10'd 100: data_o = 16'h0C32;
            10'd 101: data_o = 16'h0C22;
            10'd 102: data_o = 16'h0C13;
            10'd 103: data_o = 16'h0C04;
            10'd 104: data_o = 16'h0BF5;
            10'd 105: data_o = 16'h0BE6;
            10'd 106: data_o = 16'h0BD8;
            10'd 107: data_o = 16'h0BCA;
            10'd 108: data_o = 16'h0BBC;
            10'd 109: data_o = 16'h0BAE;
            10'd 110: data_o = 16'h0BA0;
            10'd 111: data_o = 16'h0B93;
            10'd 112: data_o = 16'h0B86;
            10'd 113: data_o = 16'h0B79;
            10'd 114: data_o = 16'h0B6C;
            10'd 115: data_o = 16'h0B5F;
            10'd 116: data_o = 16'h0B52;
            10'd 117: data_o = 16'h0B46;
            10'd 118: data_o = 16'h0B3A;
            10'd 119: data_o = 16'h0B2E;
            10'd 120: data_o = 16'h0B22;
            10'd 121: data_o = 16'h0B16;
            10'd 122: data_o = 16'h0B0A;
            10'd 123: data_o = 16'h0AFF;
            10'd 124: data_o = 16'h0AF3;
            10'd 125: data_o = 16'h0AE8;
            10'd 126: data_o = 16'h0ADD;
            10'd 127: data_o = 16'h0AD2;
            10'd 128: data_o = 16'h0AC7;
            10'd 129: data_o = 16'h0ABD;
            10'd 130: data_o = 16'h0AB2;
            10'd 131: data_o = 16'h0AA7;
            10'd 132: data_o = 16'h0A9D;
            10'd 133: data_o = 16'h0A93;
            10'd 134: data_o = 16'h0A89;
            10'd 135: data_o = 16'h0A7F;
            10'd 136: data_o = 16'h0A75;
            10'd 137: data_o = 16'h0A6B;
            10'd 138: data_o = 16'h0A61;
            10'd 139: data_o = 16'h0A58;
            10'd 140: data_o = 16'h0A4E;
            10'd 141: data_o = 16'h0A45;
            10'd 142: data_o = 16'h0A3C;
            10'd 143: data_o = 16'h0A33;
            10'd 144: data_o = 16'h0A29;
            10'd 145: data_o = 16'h0A20;
            10'd 146: data_o = 16'h0A18;
            10'd 147: data_o = 16'h0A0F;
            10'd 148: data_o = 16'h0A06;
            10'd 149: data_o = 16'h09FD;
            10'd 150: data_o = 16'h09F5;
            10'd 151: data_o = 16'h09EC;
            10'd 152: data_o = 16'h09E4;
            10'd 153: data_o = 16'h09DC;
            10'd 154: data_o = 16'h09D4;
            10'd 155: data_o = 16'h09CB;
            10'd 156: data_o = 16'h09C3;
            10'd 157: data_o = 16'h09BB;
            10'd 158: data_o = 16'h09B4;
            10'd 159: data_o = 16'h09AC;
            10'd 160: data_o = 16'h09A4;
            10'd 161: data_o = 16'h099C;
            10'd 162: data_o = 16'h0995;
            10'd 163: data_o = 16'h098D;
            10'd 164: data_o = 16'h0986;
            10'd 165: data_o = 16'h097E;
            10'd 166: data_o = 16'h0977;
            10'd 167: data_o = 16'h0970;
            10'd 168: data_o = 16'h0968;
            10'd 169: data_o = 16'h0961;
            10'd 170: data_o = 16'h095A;
            10'd 171: data_o = 16'h0953;
            10'd 172: data_o = 16'h094C;
            10'd 173: data_o = 16'h0945;
            10'd 174: data_o = 16'h093F;
            10'd 175: data_o = 16'h0938;
            10'd 176: data_o = 16'h0931;
            10'd 177: data_o = 16'h092A;
            10'd 178: data_o = 16'h0924;
            10'd 179: data_o = 16'h091D;
            10'd 180: data_o = 16'h0917;
            10'd 181: data_o = 16'h0910;
            10'd 182: data_o = 16'h090A;
            10'd 183: data_o = 16'h0904;
            10'd 184: data_o = 16'h08FD;
            10'd 185: data_o = 16'h08F7;
            10'd 186: data_o = 16'h08F1;
            10'd 187: data_o = 16'h08EB;
            10'd 188: data_o = 16'h08E5;
            10'd 189: data_o = 16'h08DF;
            10'd 190: data_o = 16'h08D9;
            10'd 191: data_o = 16'h08D3;
            10'd 192: data_o = 16'h08CD;
            10'd 193: data_o = 16'h08C7;
            10'd 194: data_o = 16'h08C1;
            10'd 195: data_o = 16'h08BC;
            10'd 196: data_o = 16'h08B6;
            10'd 197: data_o = 16'h08B0;
            10'd 198: data_o = 16'h08AB;
            10'd 199: data_o = 16'h08A5;
            10'd 200: data_o = 16'h089F;
            10'd 201: data_o = 16'h089A;
            10'd 202: data_o = 16'h0894;
            10'd 203: data_o = 16'h088F;
            10'd 204: data_o = 16'h088A;
            10'd 205: data_o = 16'h0884;
            10'd 206: data_o = 16'h087F;
            10'd 207: data_o = 16'h087A;
            10'd 208: data_o = 16'h0875;
            10'd 209: data_o = 16'h086F;
            10'd 210: data_o = 16'h086A;
            10'd 211: data_o = 16'h0865;
            10'd 212: data_o = 16'h0860;
            10'd 213: data_o = 16'h085B;
            10'd 214: data_o = 16'h0856;
            10'd 215: data_o = 16'h0851;
            10'd 216: data_o = 16'h084C;
            10'd 217: data_o = 16'h0847;
            10'd 218: data_o = 16'h0842;
            10'd 219: data_o = 16'h083D;
            10'd 220: data_o = 16'h0839;
            10'd 221: data_o = 16'h0834;
            10'd 222: data_o = 16'h082F;
            10'd 223: data_o = 16'h082A;
            10'd 224: data_o = 16'h0826;
            10'd 225: data_o = 16'h0821;
            10'd 226: data_o = 16'h081D;
            10'd 227: data_o = 16'h0818;
            10'd 228: data_o = 16'h0813;
            10'd 229: data_o = 16'h080F;
            10'd 230: data_o = 16'h080A;
            10'd 231: data_o = 16'h0806;
            10'd 232: data_o = 16'h0802;
            10'd 233: data_o = 16'h07FD;
            10'd 234: data_o = 16'h07F9;
            10'd 235: data_o = 16'h07F4;
            10'd 236: data_o = 16'h07F0;
            10'd 237: data_o = 16'h07EC;
            10'd 238: data_o = 16'h07E8;
            10'd 239: data_o = 16'h07E3;
            10'd 240: data_o = 16'h07DF;
            10'd 241: data_o = 16'h07DB;
            10'd 242: data_o = 16'h07D7;
            10'd 243: data_o = 16'h07D3;
            10'd 244: data_o = 16'h07CE;
            10'd 245: data_o = 16'h07CA;
            10'd 246: data_o = 16'h07C6;
            10'd 247: data_o = 16'h07C2;
            10'd 248: data_o = 16'h07BE;
            10'd 249: data_o = 16'h07BA;
            10'd 250: data_o = 16'h07B6;
            10'd 251: data_o = 16'h07B2;
            10'd 252: data_o = 16'h07AE;
            10'd 253: data_o = 16'h07AB;
            10'd 254: data_o = 16'h07A7;
            10'd 255: data_o = 16'h07A3;
            10'd 256: data_o = 16'h079F;
            10'd 257: data_o = 16'h079B;
            10'd 258: data_o = 16'h0797;
            10'd 259: data_o = 16'h0794;
            10'd 260: data_o = 16'h0790;
            10'd 261: data_o = 16'h078C;
            10'd 262: data_o = 16'h0789;
            10'd 263: data_o = 16'h0785;
            10'd 264: data_o = 16'h0781;
            10'd 265: data_o = 16'h077E;
            10'd 266: data_o = 16'h077A;
            10'd 267: data_o = 16'h0776;
            10'd 268: data_o = 16'h0773;
            10'd 269: data_o = 16'h076F;
            10'd 270: data_o = 16'h076C;
            10'd 271: data_o = 16'h0768;
            10'd 272: data_o = 16'h0765;
            10'd 273: data_o = 16'h0761;
            10'd 274: data_o = 16'h075E;
            10'd 275: data_o = 16'h075A;
            10'd 276: data_o = 16'h0757;
            10'd 277: data_o = 16'h0754;
            10'd 278: data_o = 16'h0750;
            10'd 279: data_o = 16'h074D;
            10'd 280: data_o = 16'h074A;
            10'd 281: data_o = 16'h0746;
            10'd 282: data_o = 16'h0743;
            10'd 283: data_o = 16'h0740;
            10'd 284: data_o = 16'h073C;
            10'd 285: data_o = 16'h0739;
            10'd 286: data_o = 16'h0736;
            10'd 287: data_o = 16'h0733;
            10'd 288: data_o = 16'h072F;
            10'd 289: data_o = 16'h072C;
            10'd 290: data_o = 16'h0729;
            10'd 291: data_o = 16'h0726;
            10'd 292: data_o = 16'h0723;
            10'd 293: data_o = 16'h0720;
            10'd 294: data_o = 16'h071D;
            10'd 295: data_o = 16'h071A;
            10'd 296: data_o = 16'h0716;
            10'd 297: data_o = 16'h0713;
            10'd 298: data_o = 16'h0710;
            10'd 299: data_o = 16'h070D;
            10'd 300: data_o = 16'h070A;
            10'd 301: data_o = 16'h0707;
            10'd 302: data_o = 16'h0704;
            10'd 303: data_o = 16'h0701;
            10'd 304: data_o = 16'h06FE;
            10'd 305: data_o = 16'h06FB;
            10'd 306: data_o = 16'h06F9;
            10'd 307: data_o = 16'h06F6;
            10'd 308: data_o = 16'h06F3;
            10'd 309: data_o = 16'h06F0;
            10'd 310: data_o = 16'h06ED;
            10'd 311: data_o = 16'h06EA;
            10'd 312: data_o = 16'h06E7;
            10'd 313: data_o = 16'h06E4;
            10'd 314: data_o = 16'h06E2;
            10'd 315: data_o = 16'h06DF;
            10'd 316: data_o = 16'h06DC;
            10'd 317: data_o = 16'h06D9;
            10'd 318: data_o = 16'h06D7;
            10'd 319: data_o = 16'h06D4;
            10'd 320: data_o = 16'h06D1;
            10'd 321: data_o = 16'h06CE;
            10'd 322: data_o = 16'h06CC;
            10'd 323: data_o = 16'h06C9;
            10'd 324: data_o = 16'h06C6;
            10'd 325: data_o = 16'h06C4;
            10'd 326: data_o = 16'h06C1;
            10'd 327: data_o = 16'h06BE;
            10'd 328: data_o = 16'h06BC;
            10'd 329: data_o = 16'h06B9;
            10'd 330: data_o = 16'h06B6;
            10'd 331: data_o = 16'h06B4;
            10'd 332: data_o = 16'h06B1;
            10'd 333: data_o = 16'h06AF;
            10'd 334: data_o = 16'h06AC;
            10'd 335: data_o = 16'h06AA;
            10'd 336: data_o = 16'h06A7;
            10'd 337: data_o = 16'h06A5;
            10'd 338: data_o = 16'h06A2;
            10'd 339: data_o = 16'h069F;
            10'd 340: data_o = 16'h069D;
            10'd 341: data_o = 16'h069B;
            10'd 342: data_o = 16'h0698;
            10'd 343: data_o = 16'h0696;
            10'd 344: data_o = 16'h0693;
            10'd 345: data_o = 16'h0691;
            10'd 346: data_o = 16'h068E;
            10'd 347: data_o = 16'h068C;
            10'd 348: data_o = 16'h0689;
            10'd 349: data_o = 16'h0687;
            10'd 350: data_o = 16'h0685;
            10'd 351: data_o = 16'h0682;
            10'd 352: data_o = 16'h0680;
            10'd 353: data_o = 16'h067E;
            10'd 354: data_o = 16'h067B;
            10'd 355: data_o = 16'h0679;
            10'd 356: data_o = 16'h0677;
            10'd 357: data_o = 16'h0674;
            10'd 358: data_o = 16'h0672;
            10'd 359: data_o = 16'h0670;
            10'd 360: data_o = 16'h066D;
            10'd 361: data_o = 16'h066B;
            10'd 362: data_o = 16'h0669;
            10'd 363: data_o = 16'h0666;
            10'd 364: data_o = 16'h0664;
            10'd 365: data_o = 16'h0662;
            10'd 366: data_o = 16'h0660;
            10'd 367: data_o = 16'h065E;
            10'd 368: data_o = 16'h065B;
            10'd 369: data_o = 16'h0659;
            10'd 370: data_o = 16'h0657;
            10'd 371: data_o = 16'h0655;
            10'd 372: data_o = 16'h0653;
            10'd 373: data_o = 16'h0650;
            10'd 374: data_o = 16'h064E;
            10'd 375: data_o = 16'h064C;
            10'd 376: data_o = 16'h064A;
            10'd 377: data_o = 16'h0648;
            10'd 378: data_o = 16'h0646;
            10'd 379: data_o = 16'h0644;
            10'd 380: data_o = 16'h0641;
            10'd 381: data_o = 16'h063F;
            10'd 382: data_o = 16'h063D;
            10'd 383: data_o = 16'h063B;
            10'd 384: data_o = 16'h0639;
            10'd 385: data_o = 16'h0637;
            10'd 386: data_o = 16'h0635;
            10'd 387: data_o = 16'h0633;
            10'd 388: data_o = 16'h0631;
            10'd 389: data_o = 16'h062F;
            10'd 390: data_o = 16'h062D;
            10'd 391: data_o = 16'h062B;
            10'd 392: data_o = 16'h0629;
            10'd 393: data_o = 16'h0627;
            10'd 394: data_o = 16'h0625;
            10'd 395: data_o = 16'h0623;
            10'd 396: data_o = 16'h0621;
            10'd 397: data_o = 16'h061F;
            10'd 398: data_o = 16'h061D;
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
            10'd 575: data_o = 16'h0516;
            10'd 576: data_o = 16'h0515;
            10'd 577: data_o = 16'h0514;
            10'd 578: data_o = 16'h0512;
            10'd 579: data_o = 16'h0511;
            10'd 580: data_o = 16'h0510;
            10'd 581: data_o = 16'h050F;
            10'd 582: data_o = 16'h050E;
            10'd 583: data_o = 16'h050D;
            10'd 584: data_o = 16'h050C;
            10'd 585: data_o = 16'h050B;
            10'd 586: data_o = 16'h050A;
            10'd 587: data_o = 16'h0508;
            10'd 588: data_o = 16'h0507;
            10'd 589: data_o = 16'h0506;
            10'd 590: data_o = 16'h0505;
            10'd 591: data_o = 16'h0504;
            10'd 592: data_o = 16'h0503;
            10'd 593: data_o = 16'h0502;
            10'd 594: data_o = 16'h0501;
            10'd 595: data_o = 16'h0500;
            10'd 596: data_o = 16'h04FF;
            10'd 597: data_o = 16'h04FE;
            10'd 598: data_o = 16'h04FD;
            10'd 599: data_o = 16'h04FB;
            10'd 600: data_o = 16'h04FA;
            10'd 601: data_o = 16'h04F9;
            10'd 602: data_o = 16'h04F8;
            10'd 603: data_o = 16'h04F7;
            10'd 604: data_o = 16'h04F6;
            10'd 605: data_o = 16'h04F5;
            10'd 606: data_o = 16'h04F4;
            10'd 607: data_o = 16'h04F3;
            10'd 608: data_o = 16'h04F2;
            10'd 609: data_o = 16'h04F1;
            10'd 610: data_o = 16'h04F0;
            10'd 611: data_o = 16'h04EF;
            10'd 612: data_o = 16'h04EE;
            10'd 613: data_o = 16'h04ED;
            10'd 614: data_o = 16'h04EC;
            10'd 615: data_o = 16'h04EB;
            10'd 616: data_o = 16'h04EA;
            10'd 617: data_o = 16'h04E9;
            10'd 618: data_o = 16'h04E8;
            10'd 619: data_o = 16'h04E7;
            10'd 620: data_o = 16'h04E6;
            10'd 621: data_o = 16'h04E5;
            10'd 622: data_o = 16'h04E4;
            10'd 623: data_o = 16'h04E3;
            10'd 624: data_o = 16'h04E2;
            10'd 625: data_o = 16'h04E1;
            10'd 626: data_o = 16'h04E0;
            10'd 627: data_o = 16'h04DF;
            10'd 628: data_o = 16'h04DE;
            10'd 629: data_o = 16'h04DD;
            10'd 630: data_o = 16'h04DC;
            10'd 631: data_o = 16'h04DB;
            10'd 632: data_o = 16'h04DA;
            10'd 633: data_o = 16'h04D9;
            10'd 634: data_o = 16'h04D8;
            10'd 635: data_o = 16'h04D7;
            10'd 636: data_o = 16'h04D6;
            10'd 637: data_o = 16'h04D5;
            10'd 638: data_o = 16'h04D4;
            10'd 639: data_o = 16'h04D3;
            10'd 640: data_o = 16'h04D2;
            10'd 641: data_o = 16'h04D1;
            10'd 642: data_o = 16'h04D0;
            10'd 643: data_o = 16'h04CF;
            10'd 644: data_o = 16'h04CE;
            10'd 645: data_o = 16'h04CD;
            10'd 646: data_o = 16'h04CC;
            10'd 647: data_o = 16'h04CB;
            10'd 648: data_o = 16'h04CA;
            10'd 649: data_o = 16'h04C9;
            10'd 650: data_o = 16'h04C8;
            10'd 651: data_o = 16'h04C7;
            10'd 652: data_o = 16'h04C7;
            10'd 653: data_o = 16'h04C6;
            10'd 654: data_o = 16'h04C5;
            10'd 655: data_o = 16'h04C4;
            10'd 656: data_o = 16'h04C3;
            10'd 657: data_o = 16'h04C2;
            10'd 658: data_o = 16'h04C1;
            10'd 659: data_o = 16'h04C0;
            10'd 660: data_o = 16'h04BF;
            10'd 661: data_o = 16'h04BE;
            10'd 662: data_o = 16'h04BD;
            10'd 663: data_o = 16'h04BC;
            10'd 664: data_o = 16'h04BB;
            10'd 665: data_o = 16'h04BB;
            10'd 666: data_o = 16'h04BA;
            10'd 667: data_o = 16'h04B9;
            10'd 668: data_o = 16'h04B8;
            10'd 669: data_o = 16'h04B7;
            10'd 670: data_o = 16'h04B6;
            10'd 671: data_o = 16'h04B5;
            10'd 672: data_o = 16'h04B4;
            10'd 673: data_o = 16'h04B3;
            10'd 674: data_o = 16'h04B2;
            10'd 675: data_o = 16'h04B2;
            10'd 676: data_o = 16'h04B1;
            10'd 677: data_o = 16'h04B0;
            10'd 678: data_o = 16'h04AF;
            10'd 679: data_o = 16'h04AE;
            10'd 680: data_o = 16'h04AD;
            10'd 681: data_o = 16'h04AC;
            10'd 682: data_o = 16'h04AB;
            10'd 683: data_o = 16'h04AA;
            10'd 684: data_o = 16'h04AA;
            10'd 685: data_o = 16'h04A9;
            10'd 686: data_o = 16'h04A8;
            10'd 687: data_o = 16'h04A7;
            10'd 688: data_o = 16'h04A6;
            10'd 689: data_o = 16'h04A5;
            10'd 690: data_o = 16'h04A4;
            10'd 691: data_o = 16'h04A4;
            10'd 692: data_o = 16'h04A3;
            10'd 693: data_o = 16'h04A2;
            10'd 694: data_o = 16'h04A1;
            10'd 695: data_o = 16'h04A0;
            10'd 696: data_o = 16'h049F;
            10'd 697: data_o = 16'h049E;
            10'd 698: data_o = 16'h049E;
            10'd 699: data_o = 16'h049D;
            10'd 700: data_o = 16'h049C;
            10'd 701: data_o = 16'h049B;
            10'd 702: data_o = 16'h049A;
            10'd 703: data_o = 16'h0499;
            10'd 704: data_o = 16'h0499;
            10'd 705: data_o = 16'h0498;
            10'd 706: data_o = 16'h0497;
            10'd 707: data_o = 16'h0496;
            10'd 708: data_o = 16'h0495;
            10'd 709: data_o = 16'h0494;
            10'd 710: data_o = 16'h0494;
            10'd 711: data_o = 16'h0493;
            10'd 712: data_o = 16'h0492;
            10'd 713: data_o = 16'h0491;
            10'd 714: data_o = 16'h0490;
            10'd 715: data_o = 16'h048F;
            10'd 716: data_o = 16'h048F;
            10'd 717: data_o = 16'h048E;
            10'd 718: data_o = 16'h048D;
            10'd 719: data_o = 16'h048C;
            10'd 720: data_o = 16'h048B;
            10'd 721: data_o = 16'h048B;
            10'd 722: data_o = 16'h048A;
            10'd 723: data_o = 16'h0489;
            10'd 724: data_o = 16'h0488;
            10'd 725: data_o = 16'h0487;
            10'd 726: data_o = 16'h0487;
            10'd 727: data_o = 16'h0486;
            10'd 728: data_o = 16'h0485;
            10'd 729: data_o = 16'h0484;
            10'd 730: data_o = 16'h0483;
            10'd 731: data_o = 16'h0483;
            10'd 732: data_o = 16'h0482;
            10'd 733: data_o = 16'h0481;
            10'd 734: data_o = 16'h0480;
            10'd 735: data_o = 16'h047F;
            10'd 736: data_o = 16'h047F;
            10'd 737: data_o = 16'h047E;
            10'd 738: data_o = 16'h047D;
            10'd 739: data_o = 16'h047C;
            10'd 740: data_o = 16'h047C;
            10'd 741: data_o = 16'h047B;
            10'd 742: data_o = 16'h047A;
            10'd 743: data_o = 16'h0479;
            10'd 744: data_o = 16'h0478;
            10'd 745: data_o = 16'h0478;
            10'd 746: data_o = 16'h0477;
            10'd 747: data_o = 16'h0476;
            10'd 748: data_o = 16'h0475;
            10'd 749: data_o = 16'h0475;
            10'd 750: data_o = 16'h0474;
            10'd 751: data_o = 16'h0473;
            10'd 752: data_o = 16'h0472;
            10'd 753: data_o = 16'h0472;
            10'd 754: data_o = 16'h0471;
            10'd 755: data_o = 16'h0470;
            10'd 756: data_o = 16'h046F;
            10'd 757: data_o = 16'h046F;
            10'd 758: data_o = 16'h046E;
            10'd 759: data_o = 16'h046D;
            10'd 760: data_o = 16'h046C;
            10'd 761: data_o = 16'h046C;
            10'd 762: data_o = 16'h046B;
            10'd 763: data_o = 16'h046A;
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
            10'd 940: data_o = 16'h03FA;
            10'd 941: data_o = 16'h03FA;
            10'd 942: data_o = 16'h03F9;
            10'd 943: data_o = 16'h03F9;
            10'd 944: data_o = 16'h03F8;
            10'd 945: data_o = 16'h03F7;
            10'd 946: data_o = 16'h03F7;
            10'd 947: data_o = 16'h03F6;
            10'd 948: data_o = 16'h03F6;
            10'd 949: data_o = 16'h03F5;
            10'd 950: data_o = 16'h03F5;
            10'd 951: data_o = 16'h03F4;
            10'd 952: data_o = 16'h03F4;
            10'd 953: data_o = 16'h03F3;
            10'd 954: data_o = 16'h03F3;
            10'd 955: data_o = 16'h03F2;
            10'd 956: data_o = 16'h03F2;
            10'd 957: data_o = 16'h03F1;
            10'd 958: data_o = 16'h03F1;
            10'd 959: data_o = 16'h03F0;
            10'd 960: data_o = 16'h03F0;
            10'd 961: data_o = 16'h03EF;
            10'd 962: data_o = 16'h03EE;
            10'd 963: data_o = 16'h03EE;
            10'd 964: data_o = 16'h03ED;
            10'd 965: data_o = 16'h03ED;
            10'd 966: data_o = 16'h03EC;
            10'd 967: data_o = 16'h03EC;
            10'd 968: data_o = 16'h03EB;
            10'd 969: data_o = 16'h03EB;
            10'd 970: data_o = 16'h03EA;
            10'd 971: data_o = 16'h03EA;
            10'd 972: data_o = 16'h03E9;
            10'd 973: data_o = 16'h03E9;
            10'd 974: data_o = 16'h03E8;
            10'd 975: data_o = 16'h03E8;
            10'd 976: data_o = 16'h03E7;
            10'd 977: data_o = 16'h03E7;
            10'd 978: data_o = 16'h03E6;
            10'd 979: data_o = 16'h03E6;
            10'd 980: data_o = 16'h03E5;
            10'd 981: data_o = 16'h03E5;
            10'd 982: data_o = 16'h03E4;
            10'd 983: data_o = 16'h03E4;
            10'd 984: data_o = 16'h03E3;
            10'd 985: data_o = 16'h03E3;
            10'd 986: data_o = 16'h03E2;
            10'd 987: data_o = 16'h03E2;
            10'd 988: data_o = 16'h03E1;
            10'd 989: data_o = 16'h03E1;
            10'd 990: data_o = 16'h03E0;
            10'd 991: data_o = 16'h03E0;
            10'd 992: data_o = 16'h03DF;
            10'd 993: data_o = 16'h03DF;
            10'd 994: data_o = 16'h03DE;
            10'd 995: data_o = 16'h03DE;
            10'd 996: data_o = 16'h03DD;
            10'd 997: data_o = 16'h03DD;
            10'd 998: data_o = 16'h03DC;
            10'd 999: data_o = 16'h03DC;
            10'd1000: data_o = 16'h03DB;
            10'd1001: data_o = 16'h03DB;
            10'd1002: data_o = 16'h03DA;
            10'd1003: data_o = 16'h03DA;
            10'd1004: data_o = 16'h03D9;
            10'd1005: data_o = 16'h03D9;
            10'd1006: data_o = 16'h03D8;
            10'd1007: data_o = 16'h03D8;
            10'd1008: data_o = 16'h03D7;
            10'd1009: data_o = 16'h03D7;
            10'd1010: data_o = 16'h03D6;
            10'd1011: data_o = 16'h03D6;
            10'd1012: data_o = 16'h03D5;
            10'd1013: data_o = 16'h03D5;
            10'd1014: data_o = 16'h03D4;
            10'd1015: data_o = 16'h03D4;
            10'd1016: data_o = 16'h03D3;
            10'd1017: data_o = 16'h03D3;
            10'd1018: data_o = 16'h03D2;
            10'd1019: data_o = 16'h03D2;
            10'd1020: data_o = 16'h03D1;
            10'd1021: data_o = 16'h03D1;
            10'd1022: data_o = 16'h03D0;
            10'd1023: data_o = 16'h03D0;
            default: data_o = 16'h0000;
        endcase
    end

endmodule


`timescale 1ns/1ps

// ============================================================
// Module: GammaLUT_Blocks0Norm1_Case
// Gamma ROM for blocks.0.norm1.
// Input meaning  : channel address c = 0..383.
// Output meaning : gamma[c] in signed INT16 Q2.14.
// Entries: 384 x 16-bit.
//
// Combinational case-based ROM.
// addr_i is the ROM address, data_o is the lookup result.
// ============================================================
module GammaLUT_Blocks0Norm1_Case (
    input  logic [8:0] addr_i,
    output logic signed [15:0] data_o
);

    always_comb begin
        unique case (addr_i)
            9'd   0: data_o = 16'h0C6E;
            9'd   1: data_o = 16'h1DA6;
            9'd   2: data_o = 16'h2055;
            9'd   3: data_o = 16'h3623;
            9'd   4: data_o = 16'h35FC;
            9'd   5: data_o = 16'h30D5;
            9'd   6: data_o = 16'h14B0;
            9'd   7: data_o = 16'h0B5A;
            9'd   8: data_o = 16'h2B7E;
            9'd   9: data_o = 16'h3516;
            9'd  10: data_o = 16'h0A4E;
            9'd  11: data_o = 16'h0A72;
            9'd  12: data_o = 16'hFFD1;
            9'd  13: data_o = 16'h1950;
            9'd  14: data_o = 16'h2D5A;
            9'd  15: data_o = 16'h2374;
            9'd  16: data_o = 16'h0B82;
            9'd  17: data_o = 16'h135C;
            9'd  18: data_o = 16'h3AE5;
            9'd  19: data_o = 16'h3A53;
            9'd  20: data_o = 16'h38A2;
            9'd  21: data_o = 16'h342E;
            9'd  22: data_o = 16'h0AF1;
            9'd  23: data_o = 16'h345D;
            9'd  24: data_o = 16'h37AE;
            9'd  25: data_o = 16'h0BA4;
            9'd  26: data_o = 16'h0882;
            9'd  27: data_o = 16'h2B24;
            9'd  28: data_o = 16'h3525;
            9'd  29: data_o = 16'h2DC4;
            9'd  30: data_o = 16'h13CE;
            9'd  31: data_o = 16'h3B4D;
            9'd  32: data_o = 16'h29F7;
            9'd  33: data_o = 16'h0A73;
            9'd  34: data_o = 16'h3D88;
            9'd  35: data_o = 16'h0B3F;
            9'd  36: data_o = 16'h2450;
            9'd  37: data_o = 16'h2230;
            9'd  38: data_o = 16'h3B49;
            9'd  39: data_o = 16'h08C9;
            9'd  40: data_o = 16'h0C2B;
            9'd  41: data_o = 16'h1890;
            9'd  42: data_o = 16'h2B57;
            9'd  43: data_o = 16'h12CF;
            9'd  44: data_o = 16'h1C71;
            9'd  45: data_o = 16'h36BE;
            9'd  46: data_o = 16'h2E85;
            9'd  47: data_o = 16'h316C;
            9'd  48: data_o = 16'h3961;
            9'd  49: data_o = 16'h36D3;
            9'd  50: data_o = 16'h36D3;
            9'd  51: data_o = 16'h31FC;
            9'd  52: data_o = 16'h23FD;
            9'd  53: data_o = 16'h0D8E;
            9'd  54: data_o = 16'h16A1;
            9'd  55: data_o = 16'h0A6D;
            9'd  56: data_o = 16'h1664;
            9'd  57: data_o = 16'h36C0;
            9'd  58: data_o = 16'h2214;
            9'd  59: data_o = 16'h32A7;
            9'd  60: data_o = 16'h287B;
            9'd  61: data_o = 16'h2CDE;
            9'd  62: data_o = 16'h1E56;
            9'd  63: data_o = 16'h12F3;
            9'd  64: data_o = 16'h0F24;
            9'd  65: data_o = 16'h2449;
            9'd  66: data_o = 16'h0C47;
            9'd  67: data_o = 16'h18F1;
            9'd  68: data_o = 16'h0D24;
            9'd  69: data_o = 16'h11A1;
            9'd  70: data_o = 16'h10C7;
            9'd  71: data_o = 16'h2961;
            9'd  72: data_o = 16'h3334;
            9'd  73: data_o = 16'h11FE;
            9'd  74: data_o = 16'h2E8D;
            9'd  75: data_o = 16'h151A;
            9'd  76: data_o = 16'h0B47;
            9'd  77: data_o = 16'h07EF;
            9'd  78: data_o = 16'h0ADB;
            9'd  79: data_o = 16'h0D41;
            9'd  80: data_o = 16'h0AA1;
            9'd  81: data_o = 16'h2E35;
            9'd  82: data_o = 16'h1AB6;
            9'd  83: data_o = 16'h2D22;
            9'd  84: data_o = 16'h2D7F;
            9'd  85: data_o = 16'h1837;
            9'd  86: data_o = 16'h0AE5;
            9'd  87: data_o = 16'h0C96;
            9'd  88: data_o = 16'h0D39;
            9'd  89: data_o = 16'h22AD;
            9'd  90: data_o = 16'h1E23;
            9'd  91: data_o = 16'h09B8;
            9'd  92: data_o = 16'h1960;
            9'd  93: data_o = 16'h226B;
            9'd  94: data_o = 16'h4050;
            9'd  95: data_o = 16'h2766;
            9'd  96: data_o = 16'h3147;
            9'd  97: data_o = 16'h2A19;
            9'd  98: data_o = 16'h24B9;
            9'd  99: data_o = 16'h32C9;
            9'd 100: data_o = 16'h1665;
            9'd 101: data_o = 16'h0BB4;
            9'd 102: data_o = 16'h11ED;
            9'd 103: data_o = 16'h2B0D;
            9'd 104: data_o = 16'h3659;
            9'd 105: data_o = 16'h1010;
            9'd 106: data_o = 16'h30CA;
            9'd 107: data_o = 16'h1B10;
            9'd 108: data_o = 16'h285C;
            9'd 109: data_o = 16'hFFFF;
            9'd 110: data_o = 16'h14B3;
            9'd 111: data_o = 16'h0A9E;
            9'd 112: data_o = 16'h0E81;
            9'd 113: data_o = 16'h38C5;
            9'd 114: data_o = 16'h0971;
            9'd 115: data_o = 16'h318D;
            9'd 116: data_o = 16'h09A0;
            9'd 117: data_o = 16'h21BD;
            9'd 118: data_o = 16'hFFC8;
            9'd 119: data_o = 16'h1F4D;
            9'd 120: data_o = 16'h0F8B;
            9'd 121: data_o = 16'h109B;
            9'd 122: data_o = 16'h0EF6;
            9'd 123: data_o = 16'h368D;
            9'd 124: data_o = 16'h3772;
            9'd 125: data_o = 16'h0C32;
            9'd 126: data_o = 16'h3A46;
            9'd 127: data_o = 16'h28B8;
            9'd 128: data_o = 16'h0D0E;
            9'd 129: data_o = 16'h2627;
            9'd 130: data_o = 16'h0C47;
            9'd 131: data_o = 16'h0D42;
            9'd 132: data_o = 16'h200D;
            9'd 133: data_o = 16'h0E46;
            9'd 134: data_o = 16'h376D;
            9'd 135: data_o = 16'h2CF2;
            9'd 136: data_o = 16'h0AA1;
            9'd 137: data_o = 16'h1BF1;
            9'd 138: data_o = 16'h19BB;
            9'd 139: data_o = 16'h13EE;
            9'd 140: data_o = 16'h2095;
            9'd 141: data_o = 16'h334F;
            9'd 142: data_o = 16'h2955;
            9'd 143: data_o = 16'h2C04;
            9'd 144: data_o = 16'h08CB;
            9'd 145: data_o = 16'h088A;
            9'd 146: data_o = 16'h3B91;
            9'd 147: data_o = 16'h0FAB;
            9'd 148: data_o = 16'h07A4;
            9'd 149: data_o = 16'h1B4D;
            9'd 150: data_o = 16'h2B13;
            9'd 151: data_o = 16'h1268;
            9'd 152: data_o = 16'h2C49;
            9'd 153: data_o = 16'h3467;
            9'd 154: data_o = 16'h0D73;
            9'd 155: data_o = 16'h2BFF;
            9'd 156: data_o = 16'h098A;
            9'd 157: data_o = 16'h10DF;
            9'd 158: data_o = 16'h1038;
            9'd 159: data_o = 16'h0C32;
            9'd 160: data_o = 16'h1282;
            9'd 161: data_o = 16'h2318;
            9'd 162: data_o = 16'h250F;
            9'd 163: data_o = 16'h3E3E;
            9'd 164: data_o = 16'h094F;
            9'd 165: data_o = 16'h2737;
            9'd 166: data_o = 16'h3AB2;
            9'd 167: data_o = 16'h35E6;
            9'd 168: data_o = 16'h1773;
            9'd 169: data_o = 16'h0C89;
            9'd 170: data_o = 16'h2EB9;
            9'd 171: data_o = 16'h10A4;
            9'd 172: data_o = 16'h0B4A;
            9'd 173: data_o = 16'h0C66;
            9'd 174: data_o = 16'h14F1;
            9'd 175: data_o = 16'h217E;
            9'd 176: data_o = 16'h3094;
            9'd 177: data_o = 16'h0961;
            9'd 178: data_o = 16'h0B7F;
            9'd 179: data_o = 16'h1622;
            9'd 180: data_o = 16'h1E80;
            9'd 181: data_o = 16'h2012;
            9'd 182: data_o = 16'h0AC0;
            9'd 183: data_o = 16'h0DF8;
            9'd 184: data_o = 16'h238B;
            9'd 185: data_o = 16'h2942;
            9'd 186: data_o = 16'h0AED;
            9'd 187: data_o = 16'h0975;
            9'd 188: data_o = 16'h32A0;
            9'd 189: data_o = 16'h1AF5;
            9'd 190: data_o = 16'h0A6D;
            9'd 191: data_o = 16'h0A74;
            9'd 192: data_o = 16'h1383;
            9'd 193: data_o = 16'h334E;
            9'd 194: data_o = 16'h1B5D;
            9'd 195: data_o = 16'h09AE;
            9'd 196: data_o = 16'h34AE;
            9'd 197: data_o = 16'h32AE;
            9'd 198: data_o = 16'h1BB2;
            9'd 199: data_o = 16'h099B;
            9'd 200: data_o = 16'h1678;
            9'd 201: data_o = 16'h34C9;
            9'd 202: data_o = 16'h0A5D;
            9'd 203: data_o = 16'h2F34;
            9'd 204: data_o = 16'h0D3B;
            9'd 205: data_o = 16'h076C;
            9'd 206: data_o = 16'h1B08;
            9'd 207: data_o = 16'h27C2;
            9'd 208: data_o = 16'h1A3A;
            9'd 209: data_o = 16'h25B4;
            9'd 210: data_o = 16'h0AE7;
            9'd 211: data_o = 16'h2CD1;
            9'd 212: data_o = 16'h0C94;
            9'd 213: data_o = 16'h0CBA;
            9'd 214: data_o = 16'h3421;
            9'd 215: data_o = 16'h36DB;
            9'd 216: data_o = 16'h0AAB;
            9'd 217: data_o = 16'h328D;
            9'd 218: data_o = 16'h095E;
            9'd 219: data_o = 16'h1750;
            9'd 220: data_o = 16'h19B5;
            9'd 221: data_o = 16'h0D6F;
            9'd 222: data_o = 16'h24F3;
            9'd 223: data_o = 16'h31F9;
            9'd 224: data_o = 16'h348D;
            9'd 225: data_o = 16'h0AAC;
            9'd 226: data_o = 16'h3EDD;
            9'd 227: data_o = 16'h0A04;
            9'd 228: data_o = 16'h0B31;
            9'd 229: data_o = 16'h39AD;
            9'd 230: data_o = 16'h2D20;
            9'd 231: data_o = 16'h0A9E;
            9'd 232: data_o = 16'h20B6;
            9'd 233: data_o = 16'h26A1;
            9'd 234: data_o = 16'h0FB7;
            9'd 235: data_o = 16'h1AA4;
            9'd 236: data_o = 16'h34FF;
            9'd 237: data_o = 16'h1384;
            9'd 238: data_o = 16'h228C;
            9'd 239: data_o = 16'h2AD5;
            9'd 240: data_o = 16'h0A97;
            9'd 241: data_o = 16'h182B;
            9'd 242: data_o = 16'h0F25;
            9'd 243: data_o = 16'h0E5E;
            9'd 244: data_o = 16'h0F5F;
            9'd 245: data_o = 16'h2C45;
            9'd 246: data_o = 16'h097B;
            9'd 247: data_o = 16'h0833;
            9'd 248: data_o = 16'h17C4;
            9'd 249: data_o = 16'h3174;
            9'd 250: data_o = 16'h2F5E;
            9'd 251: data_o = 16'h36F5;
            9'd 252: data_o = 16'h2DAD;
            9'd 253: data_o = 16'h0E7F;
            9'd 254: data_o = 16'h14F8;
            9'd 255: data_o = 16'h0BF8;
            9'd 256: data_o = 16'h0A9B;
            9'd 257: data_o = 16'h0B7C;
            9'd 258: data_o = 16'h1F96;
            9'd 259: data_o = 16'h2D99;
            9'd 260: data_o = 16'h0BBC;
            9'd 261: data_o = 16'h1C41;
            9'd 262: data_o = 16'h2E2C;
            9'd 263: data_o = 16'h0B9D;
            9'd 264: data_o = 16'h22DD;
            9'd 265: data_o = 16'h2251;
            9'd 266: data_o = 16'h1403;
            9'd 267: data_o = 16'h09E4;
            9'd 268: data_o = 16'h261A;
            9'd 269: data_o = 16'h22A6;
            9'd 270: data_o = 16'h175A;
            9'd 271: data_o = 16'h31E6;
            9'd 272: data_o = 16'h0ED0;
            9'd 273: data_o = 16'h1670;
            9'd 274: data_o = 16'h2F35;
            9'd 275: data_o = 16'h322D;
            9'd 276: data_o = 16'h2C88;
            9'd 277: data_o = 16'h1089;
            9'd 278: data_o = 16'h208E;
            9'd 279: data_o = 16'h2CD0;
            9'd 280: data_o = 16'h0919;
            9'd 281: data_o = 16'h2F4E;
            9'd 282: data_o = 16'h26CC;
            9'd 283: data_o = 16'h08CA;
            9'd 284: data_o = 16'h0D57;
            9'd 285: data_o = 16'h0C0C;
            9'd 286: data_o = 16'h0F4C;
            9'd 287: data_o = 16'h3374;
            9'd 288: data_o = 16'h098E;
            9'd 289: data_o = 16'h0B12;
            9'd 290: data_o = 16'h2FA7;
            9'd 291: data_o = 16'h0DD9;
            9'd 292: data_o = 16'h0B0D;
            9'd 293: data_o = 16'h0DDB;
            9'd 294: data_o = 16'h20F9;
            9'd 295: data_o = 16'h0AA6;
            9'd 296: data_o = 16'h2D25;
            9'd 297: data_o = 16'h0A4D;
            9'd 298: data_o = 16'h1608;
            9'd 299: data_o = 16'h2267;
            9'd 300: data_o = 16'h09EA;
            9'd 301: data_o = 16'h2090;
            9'd 302: data_o = 16'h1B40;
            9'd 303: data_o = 16'h34C3;
            9'd 304: data_o = 16'h195E;
            9'd 305: data_o = 16'h1913;
            9'd 306: data_o = 16'h0FBB;
            9'd 307: data_o = 16'h0887;
            9'd 308: data_o = 16'h22B2;
            9'd 309: data_o = 16'h2754;
            9'd 310: data_o = 16'h0E2D;
            9'd 311: data_o = 16'h0C1E;
            9'd 312: data_o = 16'h0B37;
            9'd 313: data_o = 16'h2C20;
            9'd 314: data_o = 16'h089C;
            9'd 315: data_o = 16'h1BCD;
            9'd 316: data_o = 16'h259E;
            9'd 317: data_o = 16'h07A9;
            9'd 318: data_o = 16'h1106;
            9'd 319: data_o = 16'h0CA8;
            9'd 320: data_o = 16'h2CAF;
            9'd 321: data_o = 16'h0AD9;
            9'd 322: data_o = 16'h2496;
            9'd 323: data_o = 16'h2E66;
            9'd 324: data_o = 16'h0E41;
            9'd 325: data_o = 16'h0BDC;
            9'd 326: data_o = 16'h1EAA;
            9'd 327: data_o = 16'h2BB1;
            9'd 328: data_o = 16'h2EFE;
            9'd 329: data_o = 16'h31B8;
            9'd 330: data_o = 16'h358E;
            9'd 331: data_o = 16'h086C;
            9'd 332: data_o = 16'h0BF9;
            9'd 333: data_o = 16'h0C21;
            9'd 334: data_o = 16'h12E3;
            9'd 335: data_o = 16'h127B;
            9'd 336: data_o = 16'h354E;
            9'd 337: data_o = 16'h2B3B;
            9'd 338: data_o = 16'h15BE;
            9'd 339: data_o = 16'h3898;
            9'd 340: data_o = 16'h210D;
            9'd 341: data_o = 16'h092C;
            9'd 342: data_o = 16'h38DF;
            9'd 343: data_o = 16'h14BF;
            9'd 344: data_o = 16'h1F34;
            9'd 345: data_o = 16'h08D4;
            9'd 346: data_o = 16'h29D4;
            9'd 347: data_o = 16'h0BD1;
            9'd 348: data_o = 16'h311B;
            9'd 349: data_o = 16'h31A0;
            9'd 350: data_o = 16'h1A9D;
            9'd 351: data_o = 16'h1DAE;
            9'd 352: data_o = 16'h189A;
            9'd 353: data_o = 16'h2EEF;
            9'd 354: data_o = 16'h29D0;
            9'd 355: data_o = 16'h1A1C;
            9'd 356: data_o = 16'h112C;
            9'd 357: data_o = 16'h36DF;
            9'd 358: data_o = 16'h09AE;
            9'd 359: data_o = 16'h20F7;
            9'd 360: data_o = 16'h2481;
            9'd 361: data_o = 16'h1746;
            9'd 362: data_o = 16'h2A66;
            9'd 363: data_o = 16'h357F;
            9'd 364: data_o = 16'h169A;
            9'd 365: data_o = 16'h2F99;
            9'd 366: data_o = 16'h1583;
            9'd 367: data_o = 16'h312B;
            9'd 368: data_o = 16'h321A;
            9'd 369: data_o = 16'h100F;
            9'd 370: data_o = 16'h2E72;
            9'd 371: data_o = 16'h320D;
            9'd 372: data_o = 16'h0984;
            9'd 373: data_o = 16'h1643;
            9'd 374: data_o = 16'h16D1;
            9'd 375: data_o = 16'h143B;
            9'd 376: data_o = 16'h1608;
            9'd 377: data_o = 16'h0B73;
            9'd 378: data_o = 16'h122A;
            9'd 379: data_o = 16'h0D24;
            9'd 380: data_o = 16'h29F5;
            9'd 381: data_o = 16'h0959;
            9'd 382: data_o = 16'h2FCB;
            9'd 383: data_o = 16'h1C28;
            default: data_o = 16'h0000;
        endcase
    end

endmodule


`timescale 1ns/1ps

// ============================================================
// Module: TokenStatSRAM_197x16
//
// Purpose:
//   Store runtime inv_rms[t] for 197 tokens.
//   Write side is driven by:
//      RMS_Stat_Accumulator -> AddrGen -> InvSqrt LUT
//   Read side is used by:
//      Streaming_RMSNorm_Unit.inv_rms_addr / inv_rms_data
//
// Note:
//   This version uses combinational read so that inv_rms_data is
//   aligned with Streaming_RMSNorm_Unit's current token address.
//   If you change this to synchronous BRAM, add a 1-cycle alignment
//   pipeline around x_in / gamma_data / inv_rms_data.
// ============================================================

module TokenStatSRAM_197x16 #(
    parameter int TOKEN_NUM = 197,
    parameter int TOKEN_AW  = 8,
    parameter int DATA_W    = 16
)(
    input  logic clk,
    input  logic rst_n,

    input  logic                 wr_valid_i,
    input  logic [TOKEN_AW-1:0]   wr_addr_i,
    input  logic [DATA_W-1:0]     wr_data_i,

    input  logic [TOKEN_AW-1:0]   rd_addr_i,
    output logic [DATA_W-1:0]     rd_data_o
);

    logic [DATA_W-1:0] mem [0:TOKEN_NUM-1];

    integer i;

    always_ff @(posedge clk or negedge rst_n) begin
        if (!rst_n) begin
            for (i = 0; i < TOKEN_NUM; i = i + 1) begin
                mem[i] <= '0;
            end
        end
        else begin
            if (wr_valid_i && (wr_addr_i < TOKEN_NUM[TOKEN_AW-1:0])) begin
                mem[wr_addr_i] <= wr_data_i;
            end
        end
    end

    always_comb begin
        if (rd_addr_i < TOKEN_NUM[TOKEN_AW-1:0])
            rd_data_o = mem[rd_addr_i];
        else
            rd_data_o = '0;
    end

endmodule
