onigiri05/AOC_final_project/DLA/PPU/src/GELU_Unit.sv

`include "ASIC.svh"

module GELU_Unit (
    input  logic                         clk,
    input  logic                         rst,
    input  logic                         en,              // FC1 輸出時的致能信號
    input  logic signed [`DATA_BITS-1:0] data_in,         // 來自 FC1 的原始高精度輸出
    output logic signed [`DATA_BITS-1:0] data_out         // 輸出給 Requant Unit 的中間估計值
);

    logic [7:0] gelu_in_mapped;
    logic [7:0] gelu_lut_out;
    
    // 實體常數查找表 ROM (256 x 8-bit)
    logic [7:0] gelu_rom [0:255];
    
    // 映射排程：依據固定點軟體模擬範圍截取適當的 8 位元作為 LUT 索引
    assign gelu_in_mapped = data_in[15:8]; 

    // 初始化硬體 ROM 常數 (由 Python 腳本量化生成)
    initial begin
        gelu_rom[0] = 8'h00; // 索引   0 (signed    0) | x= 0.000, y= 0.000
        gelu_rom[1] = 8'h0F; // 索引   1 (signed    1) | x= 0.256, y= 0.154
        gelu_rom[2] = 8'h24; // 索引   2 (signed    2) | x= 0.512, y= 0.356
        gelu_rom[3] = 8'h3C; // 索引   3 (signed    3) | x= 0.768, y= 0.598
        gelu_rom[4] = 8'h57; // 索引   4 (signed    4) | x= 1.024, y= 0.867
        gelu_rom[5] = 8'h73; // 索引   5 (signed    5) | x= 1.280, y= 1.151
        gelu_rom[6] = 8'h90; // 索引   6 (signed    6) | x= 1.536, y= 1.440
        gelu_rom[7] = 8'hAD; // 索引   7 (signed    7) | x= 1.792, y= 1.726
        gelu_rom[8] = 8'hC9; // 索引   8 (signed    8) | x= 2.048, y= 2.007
        gelu_rom[9] = 8'hE4; // 索引   9 (signed    9) | x= 2.304, y= 2.280
        gelu_rom[10] = 8'hFF; // 索引  10 (signed   10) | x= 2.560, y= 2.547
        gelu_rom[11] = 8'hFF; // 索引  11 (signed   11) | x= 2.816, y= 2.810
        gelu_rom[12] = 8'hFF; // 索引  12 (signed   12) | x= 3.072, y= 3.069
        gelu_rom[13] = 8'hFF; // 索引  13 (signed   13) | x= 3.328, y= 3.327
        gelu_rom[14] = 8'hFF; // 索引  14 (signed   14) | x= 3.584, y= 3.584
        gelu_rom[15] = 8'hFF; // 索引  15 (signed   15) | x= 3.840, y= 3.840
        gelu_rom[16] = 8'hFF; // 索引  16 (signed   16) | x= 4.096, y= 4.096
        gelu_rom[17] = 8'hFF; // 索引  17 (signed   17) | x= 4.352, y= 4.352
        gelu_rom[18] = 8'hFF; // 索引  18 (signed   18) | x= 4.608, y= 4.608
        gelu_rom[19] = 8'hFF; // 索引  19 (signed   19) | x= 4.864, y= 4.864
        gelu_rom[20] = 8'hFF; // 索引  20 (signed   20) | x= 5.120, y= 5.120
        gelu_rom[21] = 8'hFF; // 索引  21 (signed   21) | x= 5.376, y= 5.376
        gelu_rom[22] = 8'hFF; // 索引  22 (signed   22) | x= 5.632, y= 5.632
        gelu_rom[23] = 8'hFF; // 索引  23 (signed   23) | x= 5.888, y= 5.888
        gelu_rom[24] = 8'hFF; // 索引  24 (signed   24) | x= 6.144, y= 6.144
        gelu_rom[25] = 8'hFF; // 索引  25 (signed   25) | x= 6.400, y= 6.400
        gelu_rom[26] = 8'hFF; // 索引  26 (signed   26) | x= 6.656, y= 6.656
        gelu_rom[27] = 8'hFF; // 索引  27 (signed   27) | x= 6.912, y= 6.912
        gelu_rom[28] = 8'hFF; // 索引  28 (signed   28) | x= 7.168, y= 7.168
        gelu_rom[29] = 8'hFF; // 索引  29 (signed   29) | x= 7.424, y= 7.424
        gelu_rom[30] = 8'hFF; // 索引  30 (signed   30) | x= 7.680, y= 7.680
        gelu_rom[31] = 8'hFF; // 索引  31 (signed   31) | x= 7.936, y= 7.936
        gelu_rom[32] = 8'hFF; // 索引  32 (signed   32) | x= 8.192, y= 8.192
        gelu_rom[33] = 8'hFF; // 索引  33 (signed   33) | x= 8.448, y= 8.448
        gelu_rom[34] = 8'hFF; // 索引  34 (signed   34) | x= 8.704, y= 8.704
        gelu_rom[35] = 8'hFF; // 索引  35 (signed   35) | x= 8.960, y= 8.960
        gelu_rom[36] = 8'hFF; // 索引  36 (signed   36) | x= 9.216, y= 9.216
        gelu_rom[37] = 8'hFF; // 索引  37 (signed   37) | x= 9.472, y= 9.472
        gelu_rom[38] = 8'hFF; // 索引  38 (signed   38) | x= 9.728, y= 9.728
        gelu_rom[39] = 8'hFF; // 索引  39 (signed   39) | x= 9.984, y= 9.984
        gelu_rom[40] = 8'hFF; // 索引  40 (signed   40) | x=10.240, y=10.240
        gelu_rom[41] = 8'hFF; // 索引  41 (signed   41) | x=10.496, y=10.496
        gelu_rom[42] = 8'hFF; // 索引  42 (signed   42) | x=10.752, y=10.752
        gelu_rom[43] = 8'hFF; // 索引  43 (signed   43) | x=11.008, y=11.008
        gelu_rom[44] = 8'hFF; // 索引  44 (signed   44) | x=11.264, y=11.264
        gelu_rom[45] = 8'hFF; // 索引  45 (signed   45) | x=11.520, y=11.520
        gelu_rom[46] = 8'hFF; // 索引  46 (signed   46) | x=11.776, y=11.776
        gelu_rom[47] = 8'hFF; // 索引  47 (signed   47) | x=12.032, y=12.032
        gelu_rom[48] = 8'hFF; // 索引  48 (signed   48) | x=12.288, y=12.288
        gelu_rom[49] = 8'hFF; // 索引  49 (signed   49) | x=12.544, y=12.544
        gelu_rom[50] = 8'hFF; // 索引  50 (signed   50) | x=12.800, y=12.800
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
        end else if (en) begin
            gelu_lut_out <= gelu_rom[gelu_in_mapped];
        end
    end
    
    // 將 8-bit 查表結果擴展回 INT32 格式，無縫對接後級的 Requant Unit
    // 注意：因為 GELU_OUT 必定是正數 (GELU 幾乎不為負)，此處直接以 0 擴充高位元
    assign data_out = {24'b0, gelu_lut_out};

endmodule
