onigiri05/AOC_final_project/(commit log)

2026-06-15 Add RMSNorm hardware export test vectors
    [gamma_buffer_params.csv, rms_inv_sqrt_lut_B_per_layer_params.csv, rmsnorm_lut_size_report.csv]
2026-06-21 add profiling
    [group_summary.csv, optimization_impact.csv, profiling_results.csv]
2026-06-24 Clean up unused files
    [gamma_buffer_params.csv, rms_inv_sqrt_lut_B_per_layer_params.csv, rmsnorm_lut_size_report.csv]
2026-06-25 Add model_verification folder
    Add the "model_verification" folder (RMSNorm / INT8 quantization / FAttention / Bit-Width ablation), corresponding to the "ViT model optimization" section of the technical report. It contains all the software-side (Python/PyTorch) experiments used to validate model feasibility before DLA RTL design
    [full_summary.csv, mcnemar_all.csv]
2026-06-26 update profiling
    [group_summary.csv, optimization_impact.csv, profiling_results.csv]
